leexianhui/CG4002/hardware/2 players/README.md

# 2 players

Firmware for the six ESP32 boards (three per player), plus a laptop-side
listener for their debug and result output.

| Board | Player 1 | Player 2 |
|---|---|---|
| Right wrist (hub) | `p1_right_wrist/p1_right_wrist.ino` | `p2_right_wrist/p2_right_wrist.ino` |
| Torso | `p1_torso/p1_torso.ino` | `p2_torso/p2_torso.ino` |
| Left wrist | `p1_left_wrist/p1_left_wrist.ino` | `p2_left_wrist/p2_left_wrist.ino` |

Open a board's folder in the Arduino IDE (board: ESP32 Dev Module) and upload.
The player 1 and player 2 sketches are identical except for `PLAYER_ID`, so any
change to one must be made to both. Label the boards, because a player 2 board
flashed with a player 1 sketch pairs with the wrong player.

## How it works

1. **Waiting.** Each board calibrates its gyro at boot, so keep it still.
   The LEDs blink amber until the hub hears fresh poses from both the torso
   and the left wrist.
2. **Weapon detection.** The hub (right wrist) compares both wrists' gravity
   directions against a reference stance for each weapon (sword & shield,
   spear, mace). Holding one stance steadily for 3 s locks that weapon. The
   LEDs are green while sampling and blue while a stance is being held.
3. **Locked.** The weapon stays fixed until reboot, and the LEDs show its
   colour (cyan, magenta or orange). The hub splits its own motion into
   candidate actions, and each candidate into strokes. A stroke is one
   coherent rotation, measured relative to its own peak, so a slow swing is
   found the same way as a fast one.

   Each stroke is compared with a strike template for every action. A
   template records which way the arm rotates, which way the hand is pushed,
   how far the arm turns, and how much the torso turns with it. The torso's
   beacons supply the torso data.

   A thrust barely rotates, so it's found as a push stroke instead: a burst
   of linear acceleration, with gravity tracked by the gyro. It's compared
   with a thrust template on three measures: push direction, how far the hand
   travels before it stops, and how little the wrist turns. A push is
   rejected if it is the lead-in to a swing in the same candidate.

   - **Accepted:** the stroke is close enough to its nearest template
     (the locked weapon's `ACTION_LIMITS` distance, with the sword/shield live-play
     tolerances below) and isn't the return to guard after the strike
     before it. It gives a short buzz and a green flash, and the hub asks the
     torso for the same time window of its samples.
   - **Rejected:** a red flash.

   Segmentation uses each stroke's relative peak. Some acceptance safeguards
   below also use absolute speed and duration. Every stroke is logged as a
   `Stroke ...` debug line with its features and decision.

   The templates are fitted from recordings by `fit_strike_model.py`, which
   writes weapon-specific strike, thrust, and limit tables into both hub
   sketches. The current rows were fitted from the 76 labeled player 1 debug
   sessions, including five explicitly attested grip overrides.
   Refit after changing how a board is strapped on.
   `speed_study.py` checks a model offline before you flash it.

   The sword/shield hubs also apply narrow tolerances from the 2026-10-19
   labeled player 1 captures. Horizontal and diagonal strikes allow distance
   1.75 instead of 1.50. A missed uppercut may use a 35-degree axis spread
   and distance 2.25 only when it rotates at least 60 degrees, peaks above
   250 dps, and has torso ratio at least 0.070. This keeps recorded guard
   raises from passing the wider match. Thrust allows 65 degrees of wrist
   rotation before a penalty. Its distance limit is 1.50 for pushes peaking
   at least 1.50 g, and 1.10 for weaker pushes (the fitted limit is 1.00).
   A push rotating over 55 degrees must travel at least 0.65 m so a recorded
   flick does not pass the wider thrust check. These adjustments are outside the
   generated model block and are applied only to sword/shield. The fitter's
   printed limits describe the generated baseline; check these live-play
   allowances with fresh labeled captures after flashing.

   Player 2 also accepts a second sword/shield uppercut wrist orientation seen
   in the 2026-10-21 `uppercut` capture. It requires a full swing (at least
   350 dps and 60 degrees of rotation), torso participation, and a close
   match to that capture's axis and push direction. The same conditional code
   is in both hub sketches, but activates only for `PLAYER_ID=2`. Recheck
   uppercuts and accidental accepts on the physical boards after flashing.

   Both hubs cap the normalised rotation-angle error at +/-0.75 for all
   rotation strikes. Uppercuts have no angle penalty from 60 to 220 degrees
   and an axis spread of at least 35 degrees, including the alternate player 2
   grip. Outside that reference range the angle penalty grows gradually and
   is capped; this is not a hard accepted-angle range. The uppercut speed and
   torso gates still apply.

   Spins retain the 250-degree minimum coherent wrist rotation, but have no
   angle penalty from 250 to 720 degrees. Spin matching allows at least a
   45-degree axis spread, a 60-degree push-direction spread, and distance 2.25.
   A matched spin is exempt from return-to-guard suppression, including after
   a non-spin strike. Torso data is still required. These allowances favour
   fewer missed attacks and may admit more handling movements; validate with
   multiple players and the non-action recordings below. A spin split into
   strokes below 250 degrees can still miss; inspect the stroke logs before
   reducing that minimum or changing segmentation.

   These runtime allowances are outside the generated tables. Offline fit and
   replay results do not validate them unless the same policies are implemented
   in those tools; confirm behaviour on the boards after flashing.

   The November 2026 P2 captures add recorded forward-stroke variants to the
   action patterns in both hubs. Each stroke is scored against the original
   and recorded patterns in one matching pass. When committing an event, an
   original accept has priority; a candidate with no original accept may emit
   its best recorded-pattern match. That match keeps separate return history
   so it cannot suppress a later original accept. It emits at most one added
   segment per candidate.
   The examples and inferred attempt windows are generated by
   `python hardware/lenient_p2.py --write` from the archived
   `logs/himeth_v1` captures and Lin's newer `logs/p2` mace-thrust capture.
   Mace thrust also allows distance 0.95 (fitted limit 0.75); a recorded
   high-rotation thrust supplies one additional pattern. Review
   `hardware/p2_attempts.csv` because the recordings have no explicit
   per-repetition boundaries. Run `python hardware/lenient_p2.py` to audit
   logged-feature coverage without rewriting sketches. The examples also
   run on P1, so validate P1 live before relying on the added behaviour.
   The November raw CSVs contain wrist samples only, with four inferred
   windows lacking raw samples; the audit uses the firmware's logged stroke
   features and torso-beacon counts for those windows. A full raw replay
   needs the torso stream as well.
   P1 has its own bank, `P1_LENIENT_MODEL`, generated by
   `python hardware/lenient_p1.py --write` from the P1 action captures
   (`logs/himeth_v2`, 2026-11-09, all 5 actions x 3 weapons, and the
   2026-11-12 horizontals in `logs/p1`). It is wider (raw distance <=
   `P1_LENIENT_MAX_DIST` = 1.0) and matches for any locked weapon. A pattern
   must pass the commitment gate, and a pattern that would match any stroke in
   a fake/guard session (`p1`, `p2`, `p2_v1`, `p2_v2`) is pruned. Both hubs
   use both banks; the sketches differ only in `PLAYER_ID`. The `Combined`
   debug line shows `bank=p1|p2`.

   Commitment gate (`rotationCommitReject` / `pushCommitReject`, mirrored in
   `figpipe/handling.py`) runs before every accept path, fitted and lenient:
   `flick` (rotation < 60 deg), `slow` (peak < 250 dps over >= 650 ms, or
   < 320 dps over >= 750 ms; spins exempt), `guard_raise` (lift-shaped axis
   with rotation < 100 deg and torso ratio < 0.10, or torso ratio < 0.05) and
   thrust `short` (reach < 0.40 m or peak < 0.9 g). A push whose wrist
   angular speed peaks above 300 dps **and** reaches < 0.70 m is `flick`
   (flicks snap the wrist at 300-520 dps but travel <= ~0.55 m; hard real
   thrusts can reach 300-443 dps but travel 0.60-0.99 m; the push debug line
   logs the speed as `gyroPk=`). A horizontal/diagonal match with torso ratio
   < 0.08 is `torso_quiet` (flicks 0.03-0.07), unless it is a full-power cut
   (rotation >= 130 deg and peak >= 450 dps): P1's sword verticals/diagonals
   are arm-driven (torso 0.05-0.10) but turn 153-178 deg at 550-770 dps,
   while those flicks turn 68-120 deg. A stroke
   within `GUARD_EDGE_MS` (600 ms) of a guard entry or exit is rejected as
   `guarding`; swings while the guard is held count. Logged-feature replay at
   generation time (`python hardware/lenient_p1.py`): P1 forward strokes
   accepted 130 -> 257 of 292 (241 leave-one-session-out), P2 70 -> 121 of
   132, and accepts in all fake/guard sessions 161 -> 13.

   Guard state can't get stuck: the left wrist re-sends its current guard
   state every `GUARD_STATE_REPEAT_MS` (500 ms) while locked, the hub acts
   (buzz, relay `GUARD_EVENT`, `guard_state` result line) only on a change,
   and without a guard packet for `GUARD_STALE_MS` (1.5 s) a GUARDING hub
   drops to IDLE and logs `state=IDLE reason=stale`. Flash the left wrist and
   hub together: an old left wrist without repeats would have every guard
   timed out after 1.5 s.

   Guard (left wrist) compares the gravity pose with every reference of the
   locked weapon, each with its own enter/exit radius, arm distance and
   arrival speed: sword 10/20 deg, from > 80 deg away at >= 350 dps (a real
   sword guard comes up from rest; fakes start half-lowered and rise slowly);
   spear 15/25 for P2's pose and for P1's (28, -76); mace 25/35 for P2's pose
   and 20/30 for P1's. Entry needs the gyro EMA <= 100 dps for 400 ms, and
   within the last 1.5 s the arm must have been beyond every arm distance with
   the gyro EMA peaking at the arrival speed: hovering near the pose cannot
   trigger it, and each arrival allows one entry. Tune with
   `python hardware/guard_replay.py --sweep` (raw left-wrist replay); on the
   November captures it gives 4 false guard episodes (previous firmware 20)
   and 85 % guard coverage (previous 68 %).

### Mace/spear preparation rejection (November 8)

Both hub sketches carry the same policy, enabled only for `PLAYER_ID=2` because
these signatures were recorded with P2's mounting. P1's acceptance rules are
unchanged. P2 rejects recorded upward preparation signatures before updating
strike history. Otherwise a lift can pass as an uppercut and suppress the actual
diagonal cut as its return. The check applies to original and fallback matches;
a push overlapping a rejected handling stroke cannot re-enter as a thrust.
Logs report `guard_raise`, `return`, or `handling` for these rejections.

Three additional downward diagonal orientations cover the reviewed P2 mace and
spear strokes. They retain the weapon's distance and torso limits and require
at least 350 dps, 100 degrees of rotation, and duration at most 750 ms. These
conditions gate the additional variants, not all diagonal attacks. Earlier
upward mace diagonal fallback exemplars are blocked by the preparation check.

Run from `hardware`: `python -m unittest tests.test_preparation tests.test_handling tests.test_strokes`.
The checked-in [feature fixture](../tests/fixtures/p2_preparation.csv) retains
346 logged strokes, including pushes and genuine uppercuts. The seven-session
replay rejects all strokes in the two new fake captures and detects 12/12 new
mace, 9/9 archived mace, and 8/8 archived spear downward targets. Diagonal
targets are inferred from the signed downward strokes, not independently timed
annotations. Optional raw replay also checks zero fake accepts and coverage of
the 12 new mace targets. Raw segmentation and action hints can differ from the
logged features; this validates acceptance, not the separate AI classifier.
The new P2 folder contains no spear diagonal capture, so that regression uses
the archived November 6 capture. Rebuild and reflash the P2 right-wrist hub and verify live
raises, slow/fast diagonals, and genuine uppercuts on P2.

## Recording and fitting weapon-specific actions

Use the same sensor mounting for both players. Record one player at a time so
each session has a unique timestamp. The fitter reads the hub's `Stroke` debug
lines, and checks each session's filename weapon against its periodic
`Active weapon=<name>` line. The lock line is now available with `RAW_STREAM 0`;
raw samples are optional diagnostics and are not used for fitting.

For each of `sword_shield`, `spear`, and `mace`, record at least eight clear
repetitions of each of the six actions at slow, normal, and fast speeds. Record one session
each of `fake_flick`, `fake_handling`, `fake_walking`,
`fake_body_turn`, and `guard_raise`. For example:

```
python listener_2p.py --players 1 --label vertical_slow_spear
python listener_2p.py --players 1 --label fake_handling_spear
```

The fitter reports usable counts and stops if any action and speed group has
fewer than eight. The debug log must contain all `Stroke` lines and the closing
`Candidate ENDED` line for a thrust candidate. Inspect the printed training
comparison, especially thrust misses and non-action accepts, before using
`--write`.

The 2026-10-13 training check found mace thrust at 5/10 slow, 6/10 normal,
and 13/22 fast with the selected limit. Raising that limit admitted more
recorded non-actions, so test mace thrust and handling carefully after flashing.
Some sword/shield diagonals were accepted as another strike type; verify action
identity as well as detection in live play.

The hub keeps its weapon lock until reboot. Reboot it before changing weapon,
hold the new weapon's ready stance until it locks, and confirm the matching
`Active weapon=<name>` line before starting each labeled capture. Five
2026-10-13 spear/mace top-ups logged `Active weapon=sword_shield`; the recorder
confirmed the physical spear/mace grips. `logs/p1/weapon_grip_overrides.csv`
records those specific attestations. The fitter checks both labels and the
logged lock, retains the logged lock for diagnostics, and uses the attested
physical grip for fitting. Any other mismatch still stops fitting.

From the repository root, fit and inspect the generated model before writing:

```
python fit_strike_model.py --logs "2 players/logs/p1"
python fit_strike_model.py --logs "2 players/logs/p1" --write
```

The fitter excludes older sessions with no weapon label. The optional `_train`
suffix is equivalent to omitting a split. You can add `_val` sessions later
for a separate offline check, but they are not needed to fit the model. It fails
if a labeled session lacks a locked-weapon debug line, if the labels conflict
without a specific attestation, or if any group lacks enough usable strokes.
When `_val` recordings are supplied, it reports held-out detection and
non-action accepts against the model currently in the hub sketch. Otherwise,
flash both hubs after fitting and check detection and accidental accepts in
live play.

The hub broadcasts the current phase every 100 ms, so a board that reboots
rejoins on its own.

## Network

All six boards join the laptop hotspot set by `ssid` / `password` at the top of
each sketch. Windows Mobile Hotspot allows at most 8 clients, which leaves 2
spare. Each player's boards use their own block of UDP broadcast ports, so the
two players never process each other's packets. The `playerId` in every packet
header is checked as a second guard.

| Port | Player 1 | Player 2 | Carries |
|---|---|---|---|
| LINK | 4210 | 4220 | torso beacons, segment requests/acks (after lock) |
| DEBUG  | 4211 | 4221 | debug text -> laptop |
| POSE | 4212 | 4222 | wrist/torso poses, hub phase status |
| RESULT | 4213 | 4223 | milestone lines -> laptop |

## Build options

These are set at the top of each sketch.

| Option | Default | Effect |
|---|---|---|
| `PLAYER_ID` | 1 / 2 | Which player the board belongs to |
| `WIFI_SLEEP_DISABLED` | 1 | Turns modem sleep off for lower, steadier latency |
| `LATENCY_TEST` | 0 | Hub pings the torso and logs RTT and beacon inter-arrival times. Set it on both the hub and the torso |
| `LOCAL_FEEDBACK_TRIGGERS` | 1 | Hub drives its own LED/buzz feedback. Set to 0 when the laptop drives it |
| `RAW_STREAM` | 1 for the current P2 hub/torso sketches; 0 elsewhere | Hub and torso stream every IMU sample on port 4214/4224, for recordings. The listener writes it to `raw_<time>_<label>.csv`. Keep it enabled on both the hub and the torso when collecting raw data |

## Listening on the laptop

```
python listener_2p.py --label <label>
```

This prints every line tagged `P1`/`P2`, with a `*` marking result lines, and
writes per-player CSVs:

```
logs/p1/debug_<time>_<label>.csv   logs/p1/result_<time>_<label>.csv
logs/p2/debug_<time>_<label>.csv   logs/p2/result_<time>_<label>.csv
logs/pN/raw_<time>_<label>.csv      (RAW_STREAM builds: one row per IMU sample)
```

For speed recordings, use labels like `vertical_slow`, `vertical_normal` and
`vertical_fast`. The `logs/` folder isn't in git, so back it up.

Use `--players 2` to listen to one player only. Use `--results-only` to hide
debug lines on screen; they are still logged.
