leexianhui/CG4002/hardware/gateway/README.md

# Real hardware gateway integration

Builds the **actual imported two-player sketches** in `hardware/2 players/`.
The right-wrist hub is the final board in that supplied topology. By default every link is BLE
and no board starts Wi-Fi (`CG_GATEWAY_NODE_LINK=1`):

```text
left wrist -- BLE node link --+
torso ------ BLE node link --+--> right-wrist hub -- BLE v1 --> relay
                                   (own IMU too; central to its nodes, peripheral to the relay)
```

Why: the ESP32 has one 2.4 GHz radio. With the hardware team's Wi-Fi links the hub time-shared it
between Wi-Fi (nodes) and BLE (relay), and stopped hearing its nodes once the relay connected (all
LEDs stuck yellow). Wi-Fi also used heap the BLE stack needed: with the segment uplink added, the hub
had 91 KB free before BLE init and Bluedroid aborted (`assert failed: vQueueDelete`). Without Wi-Fi
the hub's static RAM drops from 105,932 to 88,772 bytes and no Wi-Fi driver heap is allocated.

**Node link (`src/link.cpp`, `include/gateway_link.h`).** Each node is a GATT server advertising a
player- and role-specific service UUID (`4347<player><role>-6c69-6e6b-8000-000000000000`, names
`CG-P1-TORSO`, `CG-P1-LEFT`, ...), so a hub only ever connects to its own player's nodes. The hub
scans (20 ms of every 80 ms, only while a node is missing), connects, subscribes to the node's notify
characteristic (`...01`) and writes to its write characteristic (`...02`, no response): three
connections in all, the controller's limit. Either side reconnects on its own. The sketches'
send/receive code is unchanged: their `WiFiUDP` sockets become `GatewayLinkUdp`, a drop-in with the
same calls. A packet's UDP port becomes a one-byte tag (LINK, POSE, and the continuous-mode sample
port); HubStatus goes to both nodes, LINK (beacons, segment requests/acks) only to the torso. The
laptop-only ports (DEBUG, RESULT, RAW) are dropped; `debugLog` still prints on serial. The hub asks
for 15-30 ms connection intervals, as on the relay link. Bluedroid also reports the node links to
the relay's GATT server, so `comms/firmware/src/main.cpp` tracks the relay connection by link role
and notifies it alone.

**UDP mode (`-DCG_GATEWAY_NODE_LINK=0` on all three boards of a player).** The hardware team's
original Wi-Fi UDP broadcast on their hotspot, for their laptop listener and recording tools
(`listener_2p.py`, `fit_strike_model.py`). The hub then has its old memory budget again, which the
event-mode segment queue no longer fits: if it reboot-loops at BLE init, also add
`-DCG_GATEWAY_EVENT_MODE=0`, or record with the hardware team's own non-gateway sketches.

Most integration code lives here. The six teammate sketches have opt-in `CG_HARDWARE_GATEWAY`
hooks for initialization, sample export, and (node link) swapping their Wi-Fi join and sockets. Hubs also poll incoming samples and drive the existing
motor pin from authenticated engine feedback. Left wrists keep sampling after weapon lock but
still stop pose detection/broadcasts after lock. Original Arduino builds without the flag retain
their behavior. Stance detection, segmentation, templates, wiring and existing UDP messages stay
in the teammate sketches. Their `sendSegmentToUltra96` logging stub is not used as an AI result.

The shared transport lives in `comms/firmware/src/main.cpp` with explicit hardware I/O hooks;
the gateway build disables synthetic IMU data and buttons. The demo's default behavior is unchanged.
BLE handshake/retries run on a separate FreeRTOS task, with a locked sample mailbox and a bounded
feedback queue. Sensor reads, UDP and motor writes stay on the hardware main thread.

## Boundary

- Existing BLE v1 framing, encryption, UUIDs, sequences, reliable weapon/feedback and time sync.
  Firmware version 5; packet range 0x40–0x4F stays reserved.
- **Event mode (default, `CG_GATEWAY_EVENT_MODE=1`).** One classifier window per accepted action,
  holding exactly what `ai/models/ACTION_FINAL` takes: 100 rows at 50 Hz (2 s), 18 axes per row =
  right wrist, left wrist, torso. Since 2026-11-04 (before that, only the right wrist reached the AI):
  - **All three boards feed the hub.** Torso and left wrist send their 30-byte sample every 20 ms over
    the node link (the same packet as continuous mode). The hub puts its own 100 Hz samples and the
    nodes' into `GatewayHistory` (`include/gateway_segments.h`): the last 4 s on a 20 ms grid in hub
    time. Node samples are moved onto the hub clock by `GatewayNodeClock` (smallest recent
    arrival-minus-source offset, so radio jitter doesn't shift them).
  - **The hardware team's segmenter still decides what is an action.** Its `acceptSegment()` calls
    `sendSegmentToUltra96()`, which hands over the accepted stroke (plus its 25% padding). The hub
    uses only its time span: the window ends so the stroke's midpoint is row 50 (1.0 s), the position
    the AI's training data has. It waits at most 400 ms past acceptance for that (otherwise the window
    ends 400 ms after acceptance), plus 80 ms for node samples still on the radio, then copies the
    100 rows out of the history. Real samples on both sides, no padding.
  - **Matching the training boards' chip filter.** ACTION_FINAL was recorded on these same MPU6500
    boards with the chip's low-pass on (`0x1A = 4`: gyro ~20 Hz, ~9.9 ms delay; accelerometer
    unfiltered, as the training data's flat accel noise confirms) and read at 50 Hz. The game sketches
    keep the chip filter off for their own swing detection, so every board runs the AI's copy of its
    gyro through `GatewayLowPass` (`include/gateway_samples.h`: 2nd-order Butterworth, 20 Hz at
    100 Hz, ~9.8 ms delay) before every other sample is taken. The accelerometer is left as it is. The
    sketches' own detection still gets the raw readings.
  - **Validity.** A sensor present in fewer than 80 of the 100 rows is flagged not valid; the relay then
    sends the left wrist as its at-rest placeholder and the torso as absent, and the AI fills them with
    its training mean. A short gap repeats the sensor's previous row. Serial prints
    `[segment] window seg=... right=1 left=1 torso=1` for every window.
  - **Uplink.** A 3-slot queue (one sending, one waiting, one filling; when full, the oldest unsent
    window is dropped and logged; one older than 1.5 s is discarded unsent). Each window goes once as
    20 three-IMU `SEGMENT_CHUNK`s (wire_protocol.md §3, flags bit 0): 5 rows of 18 axes per 234-byte
    frame, up to 4 unACKed, each retried with identical ciphertext (150 ms, doubling, five sends). The
    relay ACKs each chunk, reassembles, and sends exactly one classifier request with `dominant`,
    `offhand` and `torso`. It still accepts an old hub's dominant-only segments (flags 0).
  - **Cost.** Hub static RAM 88,788 -> 101,316 bytes (history 8.8 KB, window queue 10.8 KB). Node links
    carry 50 Hz samples from both nodes (the torso also keeps its 50 Hz beacons).
- **Continuous mode (`-DCG_GATEWAY_EVENT_MODE=0` on hub and nodes, `segment_mode: false` on the
  relay).** Right/left wrist and torso channels in 50 Hz `SENSOR_FRAME`s, windowed by stride on the
  relay. Axes preserve the original board orientation; accel uses 2048 counts/g, gyro 16.4
  counts/degree/second, with int16 saturation.
- Both modes: internal port 4215 (P1) / 4225 (P2) (a node-link tag over BLE) carries one
  30-byte sample at 50 Hz from each non-hub node. Packed little-endian: magic u16=0x4743, version u8=1, player u8, role u8,
  reserved u8=0, boot u32, sequence u32, source_ms u32, six int16 axes. Roles: hub=0, torso=1,
  left=2. Existing diagnostic RAW streams and ports remain unchanged.
- Reject wrong identity/format, duplicate and reordered samples. A new boot can replace a stream
  after it has been stale for 100 ms. Samples older than 100 ms are omitted and wrist stale flags
  are set. This is arrival-age detection, not synchronized acquisition: peer clocks are retained
  internally but current BLE frames use the hub clock and latest received samples. Radio buffering
  and cross-board alignment must be measured before agreeing the real AI input contract.
- Continuous mode: BLE v1 has no torso stale flag. Missing torso slots are zero, which the classifier
  treats as an absent sensor (a constant block). Missing wrist slots are zero **and marked stale**,
  never silently treated as measurements. (Event mode has per-sensor valid flags instead.)
- The real locked posture selection is sent using the existing weapon-event packet. UID is all
  zeros because this hardware does not supply RFID. Selection is announced again after reconnect.
- Engine feedback codes 0–3 drive hub vibration using supplied intensity, duration and repeat count
  (150 ms between repeats; accepted bounds: 0–100%, 1–2000 ms, 1–10 repeats). ACK means queued for
  application, not proof of physical motor movement. Duplicate packets do not queue twice; a full
  queue is not ACKed, permitting retry. Local hardware feedback remains and engine vibration takes
  priority while active. LED behavior stays with the original hardware logic.
- Battery millivolts are zero because no battery telemetry is supplied; they are not measurements.
- Internal node packets (BLE node link or UDP) are unauthenticated, as the original hardware links
  were. Relay-link authentication does not authenticate their origin.

## Build and use

From this directory, set `CG_GATEWAY_PSK_HEX` to the matching relay player's existing 32-hex-digit
key in the process environment, then run:

```powershell
..\..\pio-venv\Scripts\pio.exe run -e p1_hub -e p1_torso -e p1_left
..\..\pio-venv\Scripts\pio.exe run -e p2_hub -e p2_torso -e p2_left
..\..\pio-venv\Scripts\pio.exe test -e native_test  # needs host gcc/g++ on PATH
```

Use the matching player key for each hub build. Nodes need no relay key. Keys are written only
into ignored `.pio/build/<env>/private/gateway_secret.h`; firmware binaries also contain that key.
Without a key the hub build fails. Compile checks used an all-zero dummy key: **rebuild with the
real key before uploading**. No upload is part of these commands.

Profiles select FireBeetle ESP32 for hubs and ESP32 Dev Module for other nodes. Verify each physical
board, flash size and serial port before uploading. The hub requires the supplied 3 MB app partition
(`huge_app.csv`, no OTA slot) with at least 4 MB flash; it does not fit the usual small app partition.
The selected FireBeetle profile defaults to 16 MB flash, so match that setting to the physical board.
Existing hardware Wi-Fi settings remain in the teammate sketches and are used only in UDP mode.

Serial lines that show the node link is up (BLE mode). The sketches' own `initialized at IP 0.0.0.0`
and `wifi_sleep=` lines are harmless in this mode: no Wi-Fi is started.

- Torso / left wrist: `[link] advertising as CG-P1-TORSO, waiting for the hub`, then
  `[link] hub connected`. Its LED leaves the waiting pattern once HubStatus arrives.
- Hub: `[ble] free heap after init: ...`, `[link] scanning for torso and left wrist`, then
  `[link] torso connected` and `[link] left_wrist connected`, then the sketch's `all_nodes_ready`.
- A node that drops: `[link] torso disconnected (reason 0x..), scanning again` on the hub and
  `[link] hub disconnected, advertising again` on the node; they reconnect on their own.

Scan for `CG4002-Hardware-P1` / `CG4002-Hardware-P2`. In each relay process's `.env.relay`, set
`CG_RELAY_TRANSPORT__BLE_ADDRESS`, `CG_RELAY_PSK_HEX`, `CG_RELAY_ENGINE_LINK__BEARER_TOKEN`,
`CG_RELAY_ENGINE_LINK__HOST`, `CG_RELAY_ENGINE_LINK__CA_CERT_PATH` and `CG_RELAY_ULTRA96__HOST`
as appropriate. From `comms/`, run `cg-relay --config configs/relay.hardware.p1.yaml` (or P2).
These profiles use segment mode (`windowing.segment_mode: true`). The classifier must be started
separately: the relay always
connects to the configured classifier TCP host/port. `CG_RELAY_ULTRA96__USE_MOCK=true` only bypasses
SSH tunnel setup; it does not start or select a classifier implementation.

For a first deterministic, no-combat check, run from `comms/` in a separate terminal:

```powershell
.\.venv\Scripts\python.exe -m cg_comms.mock.ultra96_sim --host 127.0.0.1 --port 8888
```

Point the relay's `CG_RELAY_ULTRA96__HOST` / `CG_RELAY_ULTRA96__PORT` at that process. Its default
reply is IDLE; use an action-result `--scenario` for repeatable combat outcomes. This verifies the
connection and gameplay pipeline, not gesture recognition. The old button `--trigger-map` does
not apply to these hardware windows. Do not start `integration_mock` alongside
real relays: that launcher also creates simulated devices and relay sessions for both players.

## Physical acceptance still required

1. Build/upload the three matching profiles for one player (**all three**: the nodes must be reflashed
   too, or they send no samples in event mode), choose a weapon, verify the BLE handshake, that
   `[ble] free heap after init` stays healthy with the larger hub RAM, that `ble_connected
   mtu_payload` is at least 234, and that each accepted swing gives `[segment] window ... right=1
   left=1 torso=1` on the hub and exactly one `segment_received` (with `left=True torso=True`) and one
   `segment_classified` on the relay. In continuous
   mode instead verify 50 Hz reception and move each wrist separately to verify role/axis mapping.
2. Swing repeatedly as fast as possible: watch for `[segment] queue full` / `undelivered` on the hub
   and `segment_abandoned` on the relay. Repeat for hub/relay reconnect and weapon reannouncement.
3. Send engine feedback, retry the same packet, confirm one queued vibration; verify PWM/duration.
4. Repeat with both players together (six node links and two relay links in one room). Measure
   node-link drops (hub `[stats]` lines), torso beacon rate (50 Hz expected), relay link loss,
   timing alignment and heap during a sustained run. Compile success does not establish these.
5. Complete phone calibration acceptance, then run with the real AI (`ai/classifier_server.py`).

Host checks on 18 October 2026 (BLE node link): all six gateway profiles, UDP-mode and
continuous-mode variants, and the demo firmware cross-compile. Nothing flashed or tested on boards.

Host checks on 17 October 2026 (event mode): 316 Python tests passed, all six gateway profiles and the
demo firmware cross-compile, and the chunk struct's field offsets were checked against the Python
layout with the ESP32 compiler. The new native segment-queue test (`test/test_segments`) is not yet
run (no host g++ here). Nothing has been flashed or tested on boards yet.

Host checks on 14 October 2026: 286 Python tests passed; both relay profiles load correctly
with environment-supplied addresses/credentials. Six native C++ boundary tests were added, but
could not execute on this machine because host gcc/g++ is absent. ESP32 cross-compilation
does not substitute for those native tests. No boards were flashed.
