leexianhui/CG4002/design_report/09_references.md

# References

1. Lara, O. D., & Labrador, M. A. (2013). A survey on human activity recognition using wearable sensors. *IEEE Communications Surveys & Tutorials, 15*(3), 1192–1209. https://doi.org/10.1109/surv.2012.110112.00192

2. Jiang, W., Ye, X., Chen, R., Su, F., Lin, M., Ma, Y., Zhu, Y., & Huang, S. (2021). Wearable on-device deep learning system for hand gesture recognition based on FPGA accelerator. *Mathematical Biosciences and Engineering, 18*(1), 132–153. https://doi.org/10.3934/mbe.2021007

3. *Accelerometer & Gyroscope Module (MPU6050)*. SunFounder Ultimate Sensor Kit documentation. https://docs.sunfounder.com/projects/ultimate-sensor-kit/en/latest/components_basic/05-component_mpu6050.html

4. NXP. *MFRC522 standard performance MIFARE and NTAG frontend*. https://www.nxp.com/docs/en/data-sheet/MFRC522.pdf

5. Espressif Systems. *ESP32-C3 series datasheet version 2.4*. https://documentation.espressif.com/esp32-c3_datasheet_en.pdf

6. DFRobot. *FireBeetle ESP32 IoT microcontroller: Unleash IoT potential*. DFRobot Wiki. https://wiki.dfrobot.com/dfr0478/

7. *WS2812B intelligent control LED integrated light source features and benefits*. https://cdn-shop.adafruit.com/datasheets/WS2812B.pdf

8. *TP4056 datasheet*. https://dlnmh9ip6v2uc.cloudfront.net/datasheets/Prototyping/TP4056.pdf

9. Espressif Systems. *ESP-NOW Programming Guide*. https://docs.espressif.com/projects/esp-now/en/latest/

10. Bluetooth SIG. (2025). *Bluetooth Core Specification Version 6.1*. https://www.bluetooth.com/specifications/specs/core-specification/

11. Fette, I., & Melnikov, A. (2011). *RFC 6455: The WebSocket Protocol*. Internet Engineering Task Force. https://www.rfc-editor.org/info/rfc6455/
