leexianhui/CG4002/docs/DETERMINISTIC_KEYBOARD_DEMO.md

# Deterministic keyboard assessment and the existing GPIO demo

For transmission-speed trials and the complete professor-facing live/video script, use
[COMMS_LIVE_AND_VIDEO_GUIDE.md](COMMS_LIVE_AND_VIDEO_GUIDE.md).

2026-09-28. This revision follows your updated instruction: random dummy selection, a modifying
board transform, and random AI events are no longer required for the keyboard demonstration.
The earlier implementation followed the original assessment brief's explicit requirements for
those three behaviours; they were demonstration fixtures, not requirements of BLE or classification.

## Physical baseline and scope

Your attached **“CG4002 Communications Architecture — Testing Completed So Far”**, dated 28 September,
is the hardware baseline. It reports successful two-player 50 Hz streaming, a bounded 75-second
trial with 74.779 seconds common coverage, keyboard-to-Unity delivery, decoded packet inspection,
1037-byte/33-chunk file upload and RAM readback with CRC/SHA-256 verification, controlled ACK loss,
and individual board/relay/classifier/engine/Unity restart recovery.

It does **not** establish actual out-of-range recovery, simultaneous 100/200 Hz performance,
the highest stable rate, or completion of the newly revised editable-keyboard demonstration.
The new code's software checks below do not turn those into completed physical tests.

Normal GPIO capture/mapping, continuous 50 Hz scheduling, file payloads/readback, `L` fault injection,
`D` packet sampling, connection management, timing profiles, endpoints and credentials are retained.
One additive display change forwards accepted weapon selections to Unity immediately, including
physical selections, using its existing `WEAPON_CHANGED` message handler.

## Controls

| Key | Operation |
|---|---|
| `a` | Ask the board to cycle its held weapon: NONE → SWORD → SPEAR → MACE → SWORD… |
| `b` | Send fixed editable variant **B** to the board; verify identity return; classify returned IMU |
| `c` | Same operation with fixed variant **C** |
| `d` | Same operation with fixed variant **D** |
| `F` | Existing file upload, CRC, RAM readback, byte/SHA-256 verification and saved returned file |
| `L`, then `F` | Existing deliberate one-upload-ACK-loss demonstration |
| `D` | Toggle sampled normal `SENSOR_FRAME` display; distinct from lowercase `d` |
| `Q` | Stop keyboard listening; streaming continues |
| Ctrl+C | Stop this relay process |

Other characters do not send assessment packets. Keys are never queued. Wait for an operation to
finish; `BUSY`, `OFFLINE`, `NO_WEAPON` and `UPSTREAM_OFFLINE` are explicit rejections. `a` needs a
streaming board and engine connection, but no prior weapon and no classifier connection. B/C/D
require a selected weapon and both upstream connections. File operations only require the board.

The physical action buttons remain independent. Keyboard `b/c/d` do not become GPIO trigger IDs
1/2/3 and do not edit the GPIO trigger map. Keyboard `a` and physical GPIO4 share the board's held
weapon, so either can advance the same existing round robin. The relay does not invent a separate
weapon sequence. A retransmitted `a` command must not cycle twice.

## What traverses the pipeline

```text
GPIO action button -> existing 50 Hz triggered capture -> normal multi-sample SENSOR_WINDOW --+
                                                                                        |
keyboard b/c/d -> fixed raw IMU -> encrypted BLE -> board identity reply                   |
             -> verify returned fields -> scale actual return -> one-sample SENSOR_WINDOW-+
                                                                                        |
                            same classifier TCP client -> ACTION_RESULT                  |
                            -> same relay confidence/correlation checks                  |
                            -> ACTION over engine WebSocket -> ACTION_RECOGNIZED -> Unity
```

The keyboard request still contains the complete real 42-byte sensor body inside its assessment
envelope. The board returns the raw sensor axes unchanged; relay conversion is the normal
accelerometer `/2048` g and gyroscope `/16.4` deg/s conversion. Timestamp/correlation metadata still
changes per transaction. This is **not** an encrypted-byte loopback or a direct action command.

The keyboard fixture remains a one-sample-per-hand `SENSOR_WINDOW`, with `triggerId=null` and a
`demoTraceId`. It does not claim to be a physical 40-sample gesture capture. The ordinary classifier
schema carries dominant/offhand samples; torso is verified in the BLE body but not classified.
Continuous sensor frames and the physical capture window builder run independently.

### Identity transform and protocol compatibility

The previous implementation had only transforms 1=negate, 2=add-keycode and 3=swap/scale.
There was no existing identity mechanism. Revision 3 adds **0=IDENTITY** for request keys b/c/d.
There is no separate transform field in the request: the key selects identity in both firmware
and Python; the reply explicitly reports `transform_id=0`, which the relay verifies along with
all returned sensor fields. Legacy arithmetic IDs remain available for low-level protocol fixtures.

`a` adds two small assessment packet types: `ASSESS_WEAPON_REQ` 0x46 (4-byte trace ID) and
`ASSESS_WEAPON_RESP` 0x47 (trace ID, device time, selected weapon; 9 bytes). They use the existing
authenticated codec, serialized operation lock, identical-request retries and board response cache.
The board invokes the existing GPIO weapon-cycle routine and announces its selection through the
existing RFID path. The correlated response can also confirm selection if that announcement is lost.
An expired/cancelled response cannot create a new action or cycle a weapon again.

Base wire version remains 1; demo firmware reports **firmware version 3**. The largest frame remains
76 bytes. Update Python and flash both boards together. New keyboard operations reject firmware
older than version 3 with a clear message. File formats are unchanged.
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
