leexianhui/CG4002/ai/models/ACTION_FINAL/confusion_matrix.png

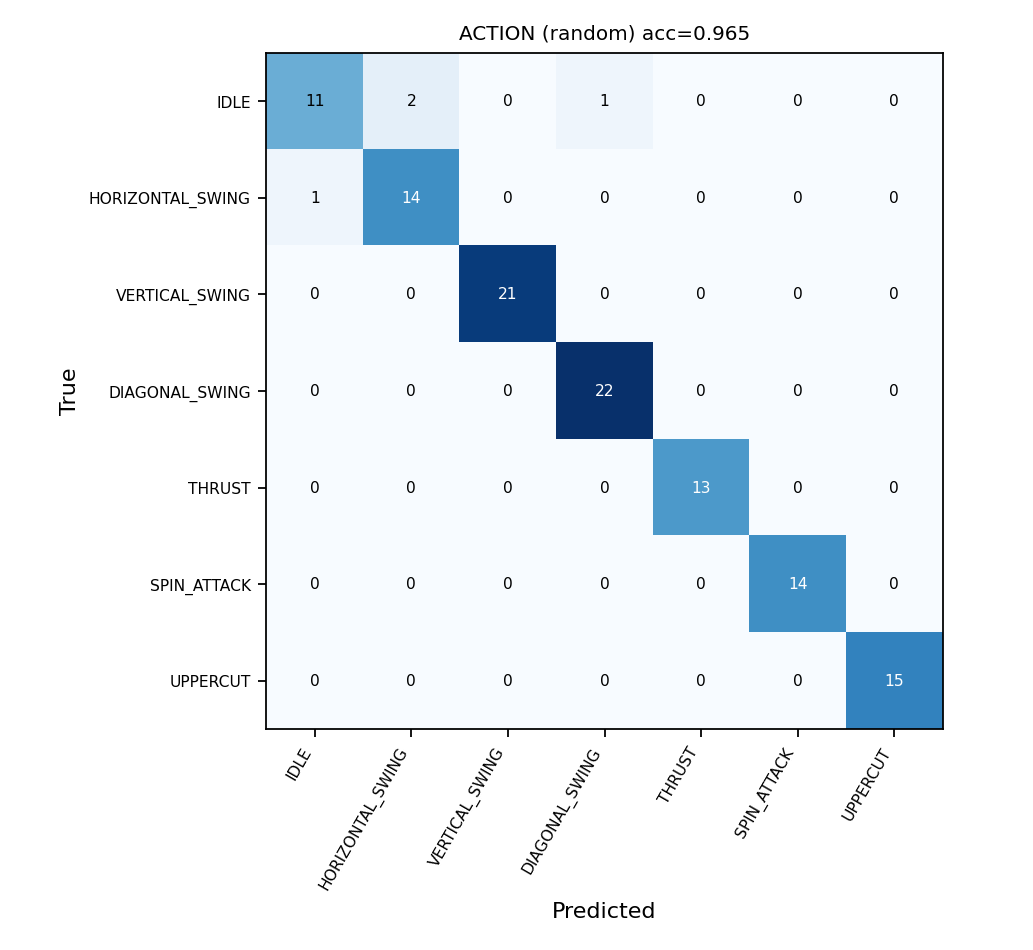
ai/models/ACTION_FINAL/confusion_matrix.png
