leexianhui/CG4002/ai/models/ACTION_FINAL/training_curves.png

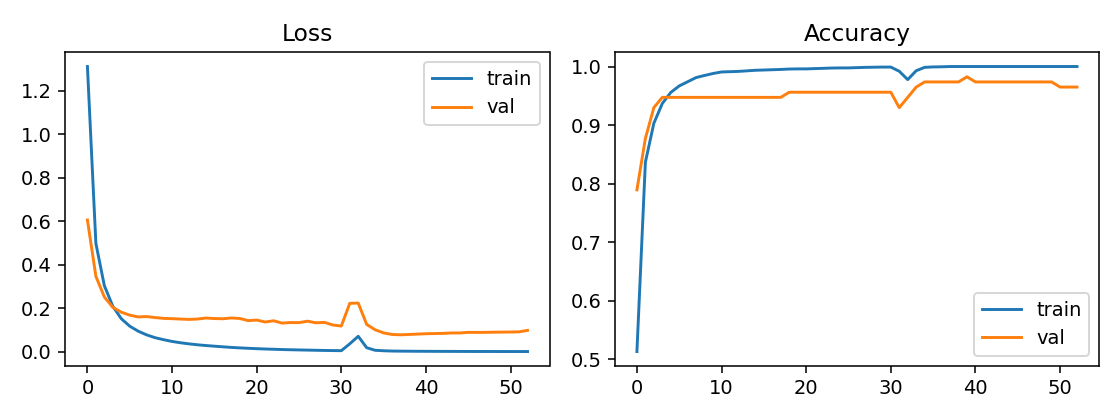
ai/models/ACTION_FINAL/training_curves.png
