leexianhui/CG4002/hardware/tests/fixtures/p2_preparation.csv

session | weapon | cand | expected | kind | t0 | t1 | peak | rot | reach | ax | ay | az | px | py | pz | torsoRatio | beacons | nearest | dist | accept
20261108_231414_fakes_mace | mace | 0 | 0 | rot | 258308 | 259161 | 245.5 | 95.3 | 0 | 0.647 | -0.715 | -0.265 | -0.186 | 0.247 | -0.951 | 0.894 | 67 | diagonal | 3.83 | 0
20261108_231414_fakes_mace | mace | 0 | 0 | rot | 259211 | 259862 | 188.4 | 55.5 | 0 | 0.577 | -0.614 | -0.538 | -0.340 | -0.858 | -0.385 | 1.033 | 44 | horizontal | 5.42 | 0
20261108_231414_fakes_mace | mace | 0 | 0 | push | 258719 | 260073 | 0.36 | 171.9 | 0.356 | -0.552 | 0.609 | 0.569 | 0 | 0 | 0 | 0 | 77 | thrust | 7.15 | 0
20261108_231414_fakes_mace | mace | 0 | 0 | push | 258850 | 259471 | 0.37 | 79.7 | 0.157 | 0.799 | 0.089 | 0.595 | 0 | 0 | 0 | 0 | 48 | thrust | 3.49 | 0
20261108_231414_fakes_mace | mace | 0 | 0 | push | 259562 | 260073 | 0.37 | 50.4 | 0.189 | 0.502 | 0.235 | 0.833 | 0 | 0 | 0 | 0 | 26 | thrust | 3.16 | 0
20261108_231414_fakes_mace | mace | 0 | 0 | push | 259822 | 260073 | 0.36 | 19.1 | 0.063 | 0.878 | 0.461 | 0.128 | 0 | 0 | 0 | 0 | 12 | thrust | 2.76 | 0
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
