leexianhui/CG4002/hardware/tests/fixtures/p2_handling.csv

session | weapon | action | reject | t0 | t1 | peak | ax | ay | az | px | py | pz
raw_20261108_214230_guard_raise_mace.csv | mace | vertical | return | 241181 | 242193 | 209.333227 | -0.095701 | -0.464007 | -0.880647 | -0.053591 | 0.734633 | -0.676345
debug_20261108_214230_guard_raise_mace.csv | mace | uppercut | guard_raise | 240125 | 240496 | 631.6 | 0.179 | 0.493 | 0.852 | 0.876 | 0.397 | -0.274
debug_20261108_214230_guard_raise_mace.csv | mace | uppercut | guard_raise | 243257 | 243598 | 641.7 | 0.096 | 0.493 | 0.865 | 0.510 | 0.721 | -0.469
debug_20261108_214230_guard_raise_mace.csv | mace | uppercut | guard_raise | 246797 | 247088 | 546.0 | 0.139 | 0.468 | 0.873 | 0.354 | 0.819 | -0.451
debug_20261108_214230_guard_raise_mace.csv | mace | vertical | return | 247692 | 248916 | 94.1 | -0.156 | -0.452 | -0.879 | 0.087 | 0.976 | 0.199
debug_20261108_214230_guard_raise_mace.csv | mace | uppercut | guard_raise | 250267 | 250568 | 516.8 | 0.179 | 0.438 | 0.881 | 0.697 | 0.500 | -0.515
debug_20261108_214230_guard_raise_mace.csv | mace | uppercut | guard_raise | 255011 | 255392 | 617.7 | 0.011 | 0.433 | 0.901 | 0.657 | 0.707 | -0.262
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
