leexianhui/CG4002/ai/models/ACTION_FINAL/history.csv

epoch | accuracy | loss | val_accuracy | val_loss | learning_rate
1 | 0.5135714411735535 | 1.3114230632781982 | 0.7894737124443054 | 0.6056737899780273 | 0.0010000000474974513
2 | 0.8366666436195374 | 0.49816685914993286 | 0.8771929740905762 | 0.34670042991638184 | 0.0010000000474974513
3 | 0.9030952453613281 | 0.3040039837360382 | 0.9298245906829834 | 0.25176897644996643 | 0.0010000000474974513
4 | 0.936904788017273 | 0.20890994369983673 | 0.9473684430122375 | 0.20393073558807373 | 0.0010000000474974513
5 | 0.9557142853736877 | 0.1518585979938507 | 0.9473684430122375 | 0.18174462020397186 | 0.0010000000474974513
6 | 0.9669047594070435 | 0.11741171777248383 | 0.9473684430122375 | 0.16813252866268158 | 0.0010000000474974513
7 | 0.9740476012229919 | 0.09441632777452469 | 0.9473684430122375 | 0.16011010110378265 | 0.0010000000474974513
8 | 0.9811905026435852 | 0.07734759896993637 | 0.9473684430122375 | 0.16150584816932678 | 0.0010000000474974513
9 | 0.9847618937492371 | 0.06445109844207764 | 0.9473684430122375 | 0.15699660778045654 | 0.0010000000474974513
10 | 0.988095223903656 | 0.05533621087670326 | 0.9473684430122375 | 0.15325921773910522 | 0.0010000000474974513
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
