leexianhui/CG4002/comms/firmware/src/main.cpp

// CG4002 Comms demo firmware — FireBeetle ESP32, BLE GATT device role.
//
// Speaks the real wire protocol (shared/protocol/wire_protocol.md) to an unmodified cg-relay over
// BLE, generating synthetic sensor data in place of real IMU/RFID hardware (this is a Comms-subsystem
// demo, not the team's real wrist/belt firmware — see comms/firmware/README.md).
//
// Flow: advertise BLE -> laptop connects & subscribes -> HELLO/HELLO_ACK -> 8x TIME_SYNC burst ->
// stream SENSOR_FRAME @50Hz + HEARTBEAT @1Hz, fire RFID_EVENT on button press, ACK incoming
// COMBAT_FEEDBACK. Mirrors comms/src/cg_comms/mock/firebeetle_sim.py's device-side behavior.

#include <Arduino.h>
#include <BLE2902.h>
#include <BLEDevice.h>
#include <BLEServer.h>
#include <BLEUtils.h>

#ifdef CG_HARDWARE_GATEWAY
#include "gateway_config.h"
#include "gateway_boundary.h"
#include "gateway_segments.h"
#include "gateway_link.h"
#include "gateway_log.h"
#include <esp_coexist.h>
#else
#include "cg_config.h"
#endif
#include "cg_frame.h"
#include "cg_protocol.h"
#include "cg_sequence.h"
#include "cg_reliable.h"
#include <freertos/FreeRTOS.h>
#include <freertos/queue.h>

namespace {

uint8_t g_psk[CG_PSK_SIZE];
uint32_t g_session_id = 0;
uint32_t g_device_nonce = 0;
CgOutgoingSequenceCounter g_tx_seq;
CgSequenceTracker g_rx_seq;
uint8_t g_weapon_id = 0;  // Weapon.NONE — see comms/src/cg_comms/messages/enums.py WIRE_VALUES

// Motion-trigger capture state (see cg_config.h CG_DEMO_ACTION_BUTTON_*). A capture is atomic: a
// new action-button press while one is already running is ignored, which is what makes one press
// yield exactly one tagged window even on a double-tap.
uint32_t g_capture_remaining = 0;
uint8_t g_capture_trigger_id = 0;

// Reliable retries keep identical authenticated ciphertext, sequence and nonce.
// A duplicate is ACKed again but never applied twice on either side.
CgReliableSend g_pending_rfid;
#ifdef CG_HARDWARE_GATEWAY
// Hub: the newest guard edge (GUARD_EVENT), ACK + identical-ciphertext retry like RFID_EVENT.
CgReliableSend g_pending_guard;
constexpr uint32_t kGuardMaxAgeMs = 1000; // an edge older than this (relay was away) is stale
// Hub: the newest weapon-candidate edge (WEAPON_CANDIDATE), same delivery as GUARD_EVENT.
CgReliableSend g_pending_candidate;
#endif
CgReliableReceiveCache g_feedback_cache;

#if defined(CG_HARDWARE_GATEWAY) && CG_GATEWAY_EVENT_MODE
// Event-mode uplink (wire_protocol.md §3 SEGMENT_CHUNK). One segment at a time; up to
// kSegmentWindow of its chunks unACKed, each retried with identical ciphertext. Runs on the BLE task.
#define CG_SEGMENT_UPLINK 1
constexpr unsigned kSegmentWindow = 4;
constexpr uint32_t kSegmentChunkTimeoutMs = 150; // first retry; doubles, five sends in all (~2.3 s)
constexpr uint32_t kSegmentMaxQueuedMs = 1500;   // an action older than this is not worth sending
CgReliableSend g_segment_tx[kSegmentWindow];
const GatewaySegment *g_segment = nullptr;
int g_segment_slot = -1;
uint8_t g_segment_next_chunk = 0, g_segment_chunks = 0;
uint32_t g_segment_started_ms = 0;
#endif

#ifndef CG_HARDWARE_GATEWAY
const uint8_t kActionButtonPins[CG_DEMO_ACTION_BUTTON_COUNT] = CG_DEMO_ACTION_BUTTON_PINS;
const uint8_t kActionButtonTriggerIds[CG_DEMO_ACTION_BUTTON_COUNT] = CG_DEMO_ACTION_BUTTON_TRIGGER_IDS;

// Debounced edge detector shared by the weapon button and every action button. `down` is the
// debounce-confirmed state; a falling edge is reported at most once per confirmed transition.
struct DebouncedButton {
    uint8_t pin;
    bool raw_down = false;
    bool down = false;
    uint32_t last_change_ms = 0;
};

DebouncedButton g_weapon_button;
DebouncedButton g_action_buttons[CG_DEMO_ACTION_BUTTON_COUNT];

// Returns true exactly once per debounced falling edge (button just went down).
bool debounce_falling_edge(DebouncedButton *btn, uint32_t now) {
    bool raw = digitalRead(btn->pin) == LOW;
    if (raw != btn->raw_down) {
        btn->raw_down = raw;
        btn->last_change_ms = now;
        return false;
    }
    if (raw != btn->down && (now - btn->last_change_ms) >= CG_DEMO_BUTTON_DEBOUNCE_MS) {
        bool falling_edge = raw && !btn->down;
        btn->down = raw;
        return falling_edge;
    }
    return false;
}

#endif
BLECharacteristic *g_notify_char = nullptr;
BLE2902 *g_notify_cccd = nullptr;  // read to tell whether the relay has subscribed yet
volatile bool g_connected = false;
volatile bool g_handshake_done = false;
volatile uint32_t g_connection_generation = 0;
// BLE callbacks and loop() run on different FreeRTOS tasks/cores. Protect the
// generation check AND handshake-state store; volatile alone cannot make them atomic.
portMUX_TYPE g_connection_mux = portMUX_INITIALIZER_UNLOCKED;
#ifdef CG_HARDWARE_GATEWAY
// The hub is also the central of its torso/left-wrist links, and Bluedroid reports those connections
// to this GATT server too (BLEServer even adds them to its notify list). Only the connection where we
// are the peripheral is the relay: track it, and notify it alone.
volatile int g_relay_conn_id = -1;
esp_gatt_if_t g_gatts_if = ESP_GATT_IF_NONE;
void capture_gatts_if(esp_gatts_cb_event_t event, esp_gatt_if_t gatts_if, esp_ble_gatts_cb_param_t *) {
    if (event == ESP_GATTS_REG_EVT) g_gatts_if = gatts_if;
}
constexpr uint8_t kLinkRolePeripheral = 1; // esp_gatts_api.h: master = 0, slave = 1
#endif

// BLECharacteristic::notify() returns void: on a controller-level failure it logs
// "esp_ble_gatts_send_notify: rc=-1" and returns, so a caller that just calls notify() cannot tell
// a delivered frame from a discarded one. The status callback below is invoked synchronously from
// inside notify() (BLECharacteristic.cpp), so reading this flag immediately after the call reports
// that send's real outcome. Without it send_packet() reported success for frames Bluedroid dropped on
// the chip, which is what made a 50 Hz stream that never left the radio look healthy on serial
// while the relay saw only a fraction of the frames (2026-09-20 span-suppression investigation).
volatile bool g_last_notify_ok = false;

class NotifyStatusCallback : public BLECharacteristicCallbacks {
    void onStatus(BLECharacteristic *characteristic, Status status, uint32_t code) override {
        g_last_notify_ok = (status == Status::SUCCESS_NOTIFY);
    }
};

// FreeRTOS queue copies writes atomically between the BLE callback and Arduino loop (it replaced a
// single mutable slot that overwrote unread ACK/feedback during bursts).
struct IncomingFrame {
    uint8_t data[CG_MAX_FRAME_SIZE];
    size_t len = 0;
};
QueueHandle_t g_incoming_queue = nullptr;
volatile uint32_t g_rx_dropped = 0;
uint32_t g_notify_dropped = 0;

uint8_t hex_nibble(char c) {
    if (c >= '0' && c <= '9') return (uint8_t)(c - '0');
    if (c >= 'a' && c <= 'f') return (uint8_t)(c - 'a' + 10);
    if (c >= 'A' && c <= 'F') return (uint8_t)(c - 'A' + 10);
    return 0;
}

void hex_to_bytes(const char *hex, uint8_t *out, size_t out_len) {
    for (size_t i = 0; i < out_len; i++) {
        out[i] = (uint8_t)((hex_nibble(hex[i * 2]) << 4) | hex_nibble(hex[i * 2 + 1]));
    }
}

class WriteCallback : public BLECharacteristicCallbacks {
    void onWrite(BLECharacteristic *characteristic) override {
        std::string value = characteristic->getValue();
        if (value.length() > CG_MAX_FRAME_SIZE) {
            return;  // oversized — not a valid frame, drop silently like a bad-length decode
        }
        IncomingFrame incoming;
        memcpy(incoming.data, value.data(), value.length());
        incoming.len = value.length();
        if (xQueueSend(g_incoming_queue, &incoming, 0) != pdTRUE) g_rx_dropped++;

    }
};

class ServerCallbacks : public BLEServerCallbacks {
    void relay_connected() {
        portENTER_CRITICAL(&g_connection_mux);
        g_connection_generation++;
        g_connected = true;
        g_handshake_done = false;
        portEXIT_CRITICAL(&g_connection_mux);
        Serial.println("[ble] connected");
    }
#ifndef CG_HARDWARE_GATEWAY
    void onConnect(BLEServer *server) override { relay_connected(); }
#endif
    // Windows picks the connection interval when we don't ask, and its default (~30-45ms) cannot
    // drain a 50Hz (20ms) stream — each interval carries fewer frames than we produce, Bluedroid's
    // tx buffer backs up, and notify() starts failing with rc=-1. Two peripherals sharing one
    // adapter halves the per-link budget again, which is why whichever board connects first (and
    // so streams for longer before the second arrives) shows it worst. Request 7.5-15ms: a
    // peripheral-initiated L2CAP connection-parameter-update, which Windows honours far more often
    // than the passive advertising hint. Only a request — the central may refuse or pick another
    // value, hence the stall counters in send_sensor_frame() rather than trusting it took.
    void onConnect(BLEServer *server, esp_ble_gatts_cb_param_t *param) override {
#ifdef CG_HARDWARE_GATEWAY
        if (param->connect.link_role != kLinkRolePeripheral) return; // a node link, not the relay
        g_relay_conn_id = param->connect.conn_id;
        relay_connected();
        // The hub's one radio is shared with the torso/left-wrist links (BLE, or Wi-Fi in UDP
        // builds). 7.5 ms connection events starved them (nodes went unheard, LEDs stayed yellow).
        // 15-30 ms still carries the 50 Hz stream: frames are batched per connection event.
        server->updateConnParams(param->connect.remote_bda, 0x0C, 0x18, 0, 400);
#else
        server->updateConnParams(param->connect.remote_bda, 0x06, 0x0C, 0, 400);
#endif
    }
#ifdef CG_HARDWARE_GATEWAY
    // A segment chunk is 234 bytes on the wire; below a 237-byte ATT MTU notify() truncates it.
    void onMtuChanged(BLEServer *server, esp_ble_gatts_cb_param_t *param) override {
        if (param->mtu.conn_id != g_relay_conn_id) return;
        Serial.printf("[ble] mtu=%u%s\n", (unsigned)param->mtu.mtu,
                      param->mtu.mtu < 237 ? " (too small for segment chunks)" : "");
    }
#endif
    void relay_disconnected(BLEServer *server) {
        portENTER_CRITICAL(&g_connection_mux);
        g_connection_generation++;
        g_connected = false;
        g_handshake_done = false;
        portEXIT_CRITICAL(&g_connection_mux);
        // Bluedroid does not clear the CCCD itself for a non-bonded central, so a stale "subscribed"
        // value would survive into the next connection and re-open the race this gate closes.
        if (g_notify_cccd != nullptr) {
            g_notify_cccd->setNotifications(false);
        }
        Serial.println("[ble] disconnected, advertising again");
        server->startAdvertising();
    }
#ifdef CG_HARDWARE_GATEWAY
    void onDisconnect(BLEServer *server, esp_ble_gatts_cb_param_t *param) override {
        if (param->disconnect.link_role != kLinkRolePeripheral) return;
        g_relay_conn_id = -1;
        relay_disconnected(server);
    }
#else
    void onDisconnect(BLEServer *server) override { relay_disconnected(server); }
#endif
};

void ble_setup() {
    g_incoming_queue = xQueueCreate(16, sizeof(IncomingFrame));
    configASSERT(g_incoming_queue != nullptr);
#ifdef CG_HARDWARE_GATEWAY
    // The hub runs the hardware algorithms too (and Wi-Fi in UDP node-link builds), and
    // BLEDevice::createServer() ran out of heap. Only BLE is used, so hand back the Classic-BT
    // controller memory (allowed only before init).
    esp_bt_controller_mem_release(ESP_BT_MODE_CLASSIC_BT);
    Serial.printf("[ble] free heap before init: %u (largest block %u)\n",
                  (unsigned)ESP.getFreeHeap(), (unsigned)ESP.getMaxAllocHeap());
#endif
    BLEDevice::init(CG_DEMO_BLE_DEVICE_NAME);
#ifdef CG_HARDWARE_GATEWAY
    BLEDevice::setMTU(247); // room for a 234-byte SEGMENT_CHUNK; the central still has to agree
    BLEDevice::setCustomGattsHandler(capture_gatts_if); // set before createServer() registers the app
#endif
    BLEServer *server = BLEDevice::createServer();
    server->setCallbacks(new ServerCallbacks());
    BLEService *service = server->createService(CG_DEMO_BLE_SERVICE_UUID);

    g_notify_char = service->createCharacteristic(
        CG_DEMO_BLE_NOTIFY_CHAR_UUID, BLECharacteristic::PROPERTY_NOTIFY);
    g_notify_char->setCallbacks(new NotifyStatusCallback());
    g_notify_cccd = new BLE2902();
    g_notify_char->addDescriptor(g_notify_cccd);

    BLECharacteristic *write_char = service->createCharacteristic(
        CG_DEMO_BLE_WRITE_CHAR_UUID, BLECharacteristic::PROPERTY_WRITE_NR | BLECharacteristic::PROPERTY_WRITE);
    write_char->setCallbacks(new WriteCallback());

    service->start();
    BLEAdvertising *advertising = BLEDevice::getAdvertising();
    advertising->addServiceUUID(CG_DEMO_BLE_SERVICE_UUID);
#if defined(CG_HARDWARE_GATEWAY) && !CG_GATEWAY_NODE_LINK
    // One 2.4 GHz radio is time-shared between BLE and the node Wi-Fi. Keep coexistence BALANCED
    // (the IDF default): PREFER_BT starved Wi-Fi so the hub stopped hearing the torso/left wrist.
    esp_coex_preference_set(ESP_COEX_PREFER_BALANCE);
#endif
    advertising->start();
#ifdef CG_HARDWARE_GATEWAY
    Serial.printf("[ble] free heap after init: %u (largest block %u)\n",
                  (unsigned)ESP.getFreeHeap(), (unsigned)ESP.getMaxAllocHeap());
#if CG_GATEWAY_NODE_LINK
    gatewayHubLinkBegin(); // central to this player's torso and left wrist, alongside the relay
#endif
#endif
}

// SUCCESS_NOTIFY means accepted by Bluedroid, NOT delivery over the air.
bool notify_frame(const uint8_t *frame, size_t frame_len) {
#ifdef CG_HARDWARE_GATEWAY
    // Straight to the relay's connection: BLECharacteristic::notify() would also send to the nodes.
    int conn = g_relay_conn_id;
    g_last_notify_ok = conn >= 0 && g_gatts_if != ESP_GATT_IF_NONE &&
                       esp_ble_gatts_send_indicate(g_gatts_if, (uint16_t)conn, g_notify_char->getHandle(),
                                                   frame_len, (uint8_t *)frame, false) == ESP_OK;
#else
    g_notify_char->setValue((uint8_t *)frame, frame_len);
    g_last_notify_ok = false;
    g_notify_char->notify();
#endif
    if (!g_last_notify_ok) g_notify_dropped++;
    return g_last_notify_ok;
}

// Encoding always consumes a fresh sequence. Reliable retries reuse these bytes, never reseal.
bool send_packet(uint8_t packet_type, const uint8_t *plaintext, size_t plaintext_len,
                  const uint8_t *cleartext_prefix, size_t cleartext_prefix_len,
                  uint16_t *wire_seq_out = nullptr, CgReliableSend *pending = nullptr) {
    uint32_t ext_seq;
    uint16_t seq = g_tx_seq.next(&ext_seq);
    uint32_t nonce_base = (packet_type == CG_PKT_HELLO) ? g_device_nonce : g_session_id;

    uint8_t frame[CG_MAX_FRAME_SIZE];
    size_t frame_len = cg_encode_frame(packet_type, seq, CG_DEMO_PLAYER_ID, plaintext, plaintext_len,
                                        cleartext_prefix, cleartext_prefix_len, g_psk, nonce_base,
                                        CG_DIR_DEVICE_TO_LAPTOP, ext_seq, frame);
    if (frame_len == 0) {
        return false;
    }
    if (wire_seq_out != nullptr) *wire_seq_out = seq;
    if (packet_type == CG_PKT_RFID_EVENT)
        g_pending_rfid.begin(frame, frame_len, seq, millis());
    if (pending != nullptr) pending->begin(frame, frame_len, seq, millis());
    return notify_frame(frame, frame_len);
}

// Blocks (with a timeout) until a frame of `expect_type` decodes successfully from the laptop.
// Returns true and fills plaintext_out/plaintext_len_out on success.
bool wait_for_packet(uint8_t expect_type, uint8_t *plaintext_out, size_t plaintext_cap,
                      size_t *plaintext_len_out, uint32_t timeout_ms) {
    uint32_t deadline = millis() + timeout_ms;
    uint32_t generation = g_connection_generation;
    while (g_connected && generation == g_connection_generation && (int32_t)(deadline - millis()) > 0) {
        IncomingFrame incoming;
        if (xQueueReceive(g_incoming_queue, &incoming, 0) == pdTRUE) {
            bool is_handshake = (expect_type == CG_PKT_HELLO_ACK);
            uint32_t nonce_base = is_handshake ? g_device_nonce : g_session_id;

            uint8_t packet_type, player_id;
            uint16_t seq;
            uint32_t ext_seq;
            // Validate length/CRC/magic/version/fragmentation before touching the replay window —
            // a frame corrupted in transit must never consume a window slot (matches codec.py's
            // check order: CRC/magic/version first, sequence_tracker.accept() only after).
            uint16_t wire_seq;
            if (!cg_frame_precheck(incoming.data, incoming.len, &wire_seq)) {
                continue;
            }
            CgSequenceTracker candidate = g_rx_seq;
            if (!candidate.accept(wire_seq, &ext_seq)) {
                continue;
            }
            size_t plaintext_len = cg_decode_frame(
                incoming.data, incoming.len, is_handshake ? 4 : 0, g_psk, nonce_base,
                CG_DIR_LAPTOP_TO_DEVICE, ext_seq, &packet_type, &seq, &player_id, plaintext_out,
                plaintext_cap);
            if (plaintext_len == 0 || packet_type != expect_type || player_id != CG_DEMO_PLAYER_ID) {
                continue;
            }
            g_rx_seq = candidate;
            *plaintext_len_out = plaintext_len;
            return true;
        }
        delay(2);
    }
    return false;
}

// Sends an ACK for `acked_seq`. Factored out so both the fresh-frame path and the
// already-seen-duplicate path (below) can answer identically — a duplicate must still be ACKed,
// since its arrival means our previous ACK was the packet that actually got lost.
void send_ack_for(uint16_t acked_seq) {
    uint8_t payload[2];  // cg_payload_ack_t
    memcpy(payload, &acked_seq, 2);
    send_packet(CG_PKT_ACK, payload, sizeof(payload), nullptr, 0);
}

uint8_t next_weapon_id() { return (g_weapon_id % 3) + 1; }

void drain_incoming_non_blocking() {
    IncomingFrame incoming;
    // Bound each turn: sensor/button work continues even under incoming bursts.
    for (unsigned i = 0; i < 16 && xQueueReceive(g_incoming_queue, &incoming, 0) == pdTRUE; i++) {
        uint16_t wire_seq;
        if (!cg_frame_precheck(incoming.data, incoming.len, &wire_seq)) continue;
        if (g_feedback_cache.contains(incoming.data, incoming.len, millis())) {
            send_ack_for(wire_seq); // exact previously authenticated COMBAT_FEEDBACK only
            continue;
        }
        CgSequenceTracker candidate = g_rx_seq;
        uint32_t ext_seq;
        bool accepted = candidate.accept(wire_seq, &ext_seq);
        const uint8_t wire_type = incoming.data[2];
        if (wire_type == CG_PKT_COMBAT_FEEDBACK) {
            // Reliable types use a monotonic watermark instead of the 64-wide window, so a first
            // arrival after several lost sends is not mistaken for a replay (mirrors codec.py).
            // wire_type is still unauthenticated here; a forged byte only picks which check is
            // applied, and the GCM check below (header is AAD) rejects the frame either way.
            int64_t inferred = g_rx_seq.infer(wire_seq);
            if (inferred <= g_feedback_cache.highest) continue;
            ext_seq = (uint32_t)inferred;
        } else if (!accepted) continue;
        uint8_t plaintext[CG_MAX_FRAME_SIZE], packet_type, player_id;
        uint16_t seq;
        size_t len = cg_decode_frame(incoming.data, incoming.len, 0, g_psk, g_session_id,
            CG_DIR_LAPTOP_TO_DEVICE, ext_seq, &packet_type, &seq, &player_id, plaintext, sizeof(plaintext));
        if (!len || player_id != CG_DEMO_PLAYER_ID) continue;
        if ((packet_type == CG_PKT_ACK && len != 2) ||
            (packet_type == CG_PKT_COMBAT_FEEDBACK && len != sizeof(cg_payload_combat_feedback_t))) continue;
#ifdef CG_HARDWARE_GATEWAY
        // Do not ACK/cache a command the hardware queue could not accept: let the relay retry.
        if (packet_type == CG_PKT_COMBAT_FEEDBACK && !gatewayQueueFeedback(plaintext)) continue;
#endif
        g_rx_seq = candidate; // commit replay state only after GCM authentication
        if (packet_type == CG_PKT_COMBAT_FEEDBACK) {
            g_feedback_cache.highest = ext_seq;
            g_feedback_cache.remember(incoming.data, incoming.len, millis());
            send_ack_for(seq);
#ifdef CG_HARDWARE_GATEWAY
            gatewayLogf("[feedback] queued seq=%u code=%u\n", (unsigned)seq, (unsigned)plaintext[0]);
#else
            Serial.printf("[feedback] applied seq=%u code=%u\n", (unsigned)seq, (unsigned)plaintext[0]);
#endif
        } else if (packet_type == CG_PKT_ACK) {
            uint16_t acked_seq;
            memcpy(&acked_seq, plaintext, 2);
            bool was_pending = g_pending_rfid.active;
            g_pending_rfid.ack(acked_seq);
            if (was_pending && !g_pending_rfid.active)
                Serial.printf("[weapon] rfid_event acked seq=%u\n", (unsigned)acked_seq);
#ifdef CG_SEGMENT_UPLINK
            for (auto &chunk : g_segment_tx) chunk.ack(acked_seq);
#endif
#ifdef CG_HARDWARE_GATEWAY
            g_pending_candidate.ack(acked_seq);
            bool guard_was_pending = g_pending_guard.active;
            g_pending_guard.ack(acked_seq);
            if (guard_was_pending && !g_pending_guard.active)
                gatewayLogf("[guard] guard_event acked seq=%u\n", (unsigned)acked_seq);
#endif
        }
    }
}

#ifdef CG_SEGMENT_UPLINK
void finish_segment(const char *outcome) {
    if (g_segment == nullptr) return;
    gatewayLogf("[segment] %s seg=%lu samples=%u chunks=%u in %lums\n", outcome,
                  (unsigned long)g_segment->id, (unsigned)g_segment->count, (unsigned)g_segment_chunks,
                  (unsigned long)(millis() - g_segment_started_ms));
    for (auto &chunk : g_segment_tx) chunk.reset();
    gatewaySegmentDone(g_segment_slot);
    g_segment = nullptr;
    g_segment_slot = -1;
}

// Sends the next chunks of the current segment as window slots free up, retries unACKed ones, and
// moves on to the next queued segment once every chunk is ACKed (or one exhausts its retries).
void service_segments() {
    uint32_t now = millis();
    if (g_segment == nullptr) {
        g_segment = gatewaySegmentTake(now, kSegmentMaxQueuedMs, g_segment_slot);
        if (g_segment == nullptr) return;
        g_segment_next_chunk = 0;
        g_segment_chunks = gatewaySegmentChunks(*g_segment);
        g_segment_started_ms = now;
    }
    bool busy = false;
    for (auto &chunk : g_segment_tx) {
        int due = chunk.poll(now);
        if (due < 0) {
            finish_segment("undelivered");
            return;
        }
        if (due > 0) notify_frame(chunk.frame, chunk.len);
        if (!chunk.active && g_segment_next_chunk < g_segment_chunks) {
            cg_payload_segment_chunk_t payload;
            gatewaySegmentChunk(*g_segment, g_segment_next_chunk++, payload);
            send_packet(CG_PKT_SEGMENT_CHUNK, (const uint8_t *)&payload, sizeof(payload), nullptr, 0,
                        nullptr, &chunk);
            chunk.timeout_ms = kSegmentChunkTimeoutMs; // ACKs return within a few connection events
            chunk.next_ms = now + kSegmentChunkTimeoutMs;
        }
        busy |= chunk.active;
    }
    if (!busy && g_segment_next_chunk >= g_segment_chunks) finish_segment("sent");
}
#endif

bool do_handshake() {
    g_tx_seq.reset();
    g_rx_seq.reset();
    g_pending_rfid.reset();
#ifdef CG_HARDWARE_GATEWAY
    g_pending_guard.reset();
    g_pending_candidate.reset();
#endif
#ifdef CG_SEGMENT_UPLINK
    finish_segment("abandoned (relay reconnected)");
#endif
    g_feedback_cache.reset();
    g_capture_remaining = 0;
    g_session_id = 0;
    xQueueReset(g_incoming_queue);
    g_device_nonce = esp_random();
    uint8_t device_mac[6];
    esp_read_mac(device_mac, ESP_MAC_BT);

    // cg_payload_hello_t, little-endian, matches PAYLOAD_TABLES[HELLO] field order exactly.
    uint8_t hello[16];
    memcpy(hello, device_mac, 6);
    hello[6] = CG_DEMO_PLAYER_ID;
    hello[7] = CG_PROTOCOL_VERSION;
    hello[8] = 4;
#ifdef CG_HARDWARE_GATEWAY
    hello[8] = 5; // real hardware boundary, same protocol v1
#endif
    hello[9] = 0;  // firmware_version = 4 (u16 LE): gameplay only, assessment extension removed
    memcpy(hello + 10, &g_device_nonce, 4);
    hello[14] = 0;
    hello[15] = 0;  // reserved

    uint8_t device_nonce_prefix[4];
    memcpy(device_nonce_prefix, &g_device_nonce, 4);

    if (!send_packet(CG_PKT_HELLO, hello, sizeof(hello), device_nonce_prefix, sizeof(device_nonce_prefix))) {
        Serial.println("[handshake] HELLO send failed");
        return false;
    }

    uint8_t ack_plaintext[32];
    size_t ack_len;
    if (!wait_for_packet(CG_PKT_HELLO_ACK, ack_plaintext, sizeof(ack_plaintext), &ack_len, 5000)) {
        Serial.println("[handshake] no HELLO_ACK");
        return false;
    }
    // cg_payload_hello_ack_t: session_id(4) | epoch_lo(4) | epoch_hi(4) | device_nonce_echo(4).
    uint32_t echoed_nonce = 0;
    if (ack_len != 16) return false;
    memcpy(&echoed_nonce, ack_plaintext + 12, 4);
    if (echoed_nonce != g_device_nonce) return false;
    memcpy(&g_session_id, ack_plaintext, 4);
    if (g_session_id == 0) {
        Serial.println("[handshake] refused (version mismatch)");
        return false;
    }
    for (int i = 0; i < 8; i++) {
        uint32_t t0 = millis();
        uint8_t req[4];
        memcpy(req, &t0, 4);
        if (!send_packet(CG_PKT_TIME_SYNC_REQ, req, sizeof(req), nullptr, 0)) {
            Serial.println("[handshake] TIME_SYNC_REQ send failed");
            return false;
        }

        uint8_t resp[16];
        size_t resp_len;
        if (!wait_for_packet(CG_PKT_TIME_SYNC_RESP, resp, sizeof(resp), &resp_len, 2000) ||
            resp_len != 12 || memcmp(resp, &t0, 4) != 0) {
            Serial.println("[handshake] TIME_SYNC_RESP timeout/mismatch");
            return false;
        }
        delay(100);
    }

    Serial.printf("[handshake] complete, session_id=0x%08X\n", g_session_id);
    return true;
}

void send_sensor_frame() {
#ifdef CG_HARDWARE_GATEWAY
    cg_payload_sensor_frame_t frame;
    gatewayReadFrame(frame);
    uint8_t payload[sizeof(frame)];
    memcpy(payload, &frame, sizeof(frame));
#else
    static float phase = 0.0f;
    phase += 0.3f;

    // Synthetic "swing" pattern: sine-wave accel/gyro on the dominant wrist, near-zero elsewhere.
    // Scaling per protocol/constants.py: accel 1 LSB = 1/2048 g, gyro 1 LSB = 1/16.4 deg/s.
    int16_t dominant[6] = {
        (int16_t)(sinf(phase) * 1.5f * 2048.0f), 0, (int16_t)(cosf(phase) * 0.5f * 2048.0f),
        (int16_t)(sinf(phase) * 200.0f * 16.4f), 0, 0,
    };
    int16_t offhand[6] = {0, 0, (int16_t)(1.0f * 2048.0f), 0, 0, 0};
    int16_t torso[6] = {0, 0, (int16_t)(1.0f * 2048.0f), 0, 0, 0};

    uint8_t flags = 0;
    if (g_capture_remaining > 0) {
        flags = CG_FLAG_MOTION_ACTIVE | ((g_capture_trigger_id & 0x7) << CG_FLAG_TRIGGER_ID_SHIFT);
        g_capture_remaining--;
    }

    uint8_t payload[42];
    uint32_t ts = millis();
    memcpy(payload, &ts, 4);
    payload[4] = flags;
    payload[5] = g_weapon_id;
    memcpy(payload + 6, dominant, 12);
    memcpy(payload + 18, offhand, 12);
    memcpy(payload + 30, torso, 12);
#endif

    // Rate-limited to 1 line/sec: at 50 Hz an unthrottled print would flood the monitor and
    // slow the loop. Without this the 50 Hz path is invisible on serial and a soak test looks
    // healthy while only heartbeats are actually flowing.
    //
    // `dropped` counts frames the controller refused (tx buffer full). It is the number that
    // matters: `sent` alone read a flat 50/s while the relay was receiving far fewer, because the
    // frames were being generated on time and discarded on-chip. sent+dropped is the generated
    // rate; `sent` counts stack acceptance only. The relay sees only
    // accepted frames; radio delivery still requires hardware validation.
    static uint32_t last_log_ms = 0;
    static uint32_t sent_since_log = 0;
    static uint32_t dropped_since_log = 0;
    if (send_packet(CG_PKT_SENSOR_FRAME, payload, sizeof(payload), nullptr, 0)) {
        sent_since_log++;
    } else {
        dropped_since_log++;
    }
    uint32_t now = millis();
    if (now - last_log_ms >= 1000) {
        last_log_ms = now;
        Serial.printf("[tx] sensor_frames=%lu/s dropped=%lu/s weapon=%u generated=%lu/s notify_dropped=%lu rx_dropped=%lu\n",
                      (unsigned long)sent_since_log, (unsigned long)dropped_since_log,
                      (unsigned)g_weapon_id, (unsigned long)(sent_since_log + dropped_since_log),
                      (unsigned long)g_notify_dropped, (unsigned long)g_rx_dropped);
        sent_since_log = 0;
        dropped_since_log = 0;
    }
}

void send_heartbeat() {
    Serial.printf("[tx] heartbeat t=%lu\n", (unsigned long)millis());
    uint8_t payload[12];
    uint32_t ts = millis();
    memcpy(payload, &ts, 4);
    uint16_t vbat = 4000, status = 0;
#ifdef CG_HARDWARE_GATEWAY
    vbat = 0; // no battery telemetry is supplied by these sketches; never invent a measurement
#endif
    memcpy(payload + 4, &vbat, 2);
    memcpy(payload + 6, &vbat, 2);
    memcpy(payload + 8, &vbat, 2);
    memcpy(payload + 10, &status, 2);
    send_packet(CG_PKT_HEARTBEAT, payload, sizeof(payload), nullptr, 0);
}

// Weapon wire values per comms/src/cg_comms/messages/enums.py WIRE_VALUES: NONE=0 SWORD=1 SPEAR=2 MACE=3.
void send_current_weapon() {
    if (g_weapon_id == 0) return;
    uint8_t payload[12];
    uint32_t ts = millis();
    memcpy(payload, &ts, 4);
    payload[4] = g_weapon_id;
    payload[5] = 0;
    uint8_t uid[6] = {0xE0, 0x04, 0x01, 0x50, CG_DEMO_PLAYER_ID, g_weapon_id};
#ifdef CG_HARDWARE_GATEWAY
    memset(uid, 0, sizeof(uid)); // posture-derived selection, no physical RFID tag
#endif
    memcpy(payload + 6, uid, 6);
    // A new selection supersedes the pending old selection, including its ACK identity.
    bool accepted = send_packet(CG_PKT_RFID_EVENT, payload, sizeof(payload), nullptr, 0);
    Serial.printf("[weapon] now %u seq=%u accepted=%u\n",
                  (unsigned)g_weapon_id, (unsigned)g_pending_rfid.seq, (unsigned)accepted);
}

void send_rfid_event_next_weapon() {
    g_weapon_id = next_weapon_id();
    send_current_weapon();
}

void service_pending_rfid_event() {
    int due = g_pending_rfid.poll(millis());
    if (due < 0) {
        Serial.printf("[weapon] rfid_event undelivered after 5 attempts, wire_seq=%u\n",
                      (unsigned)g_pending_rfid.seq);
    } else if (due > 0) {
        bool accepted = notify_frame(g_pending_rfid.frame, g_pending_rfid.len);
        Serial.printf("[weapon] rfid_event retransmit attempt=%u wire_seq=%u accepted=%u\n",
                      (unsigned)g_pending_rfid.attempts, (unsigned)g_pending_rfid.seq, (unsigned)accepted);
    }
}

#ifdef CG_HARDWARE_GATEWAY
// Hub: forwards the left wrist's newest guard edge to the relay as a reliable GUARD_EVENT. A newer
// edge supersedes an unACKed older one; an edge that waited out a relay outage is dropped.
void service_guard_events() {
    uint8_t state;
    uint32_t event_ms;
    if (gatewayTakeGuardEvent(state, event_ms)) {
        uint32_t age = millis() - event_ms;
        if (age > kGuardMaxAgeMs) {
            gatewayLogf("[guard] dropped stale edge state=%u age=%lums\n", (unsigned)state,
                        (unsigned long)age);
        } else {
            cg_payload_guard_event_t payload = {};
            payload.device_timestamp_ms = event_ms;
            payload.guard_state = state;
            payload.weapon_id = g_weapon_id;
            bool accepted = send_packet(CG_PKT_GUARD_EVENT, (const uint8_t *)&payload, sizeof(payload),
                                        nullptr, 0, nullptr, &g_pending_guard);
            gatewayLogf("[guard] guard_event %s seq=%u accepted=%u\n", state ? "GUARDING" : "IDLE",
                        (unsigned)g_pending_guard.seq, (unsigned)accepted);
        }
    }
    int due = g_pending_guard.poll(millis());
    if (due < 0)
        gatewayLogf("[guard] guard_event undelivered after 5 attempts, seq=%u\n",
                    (unsigned)g_pending_guard.seq);
    else if (due > 0)
        notify_frame(g_pending_guard.frame, g_pending_guard.len);
}

// Hub: forwards hardware debug-log pieces (its own and its nodes', gateway_log.h) to the relay as
// best-effort DEVICE_LOG packets. Lowest priority: never while a segment is going out, and at most
// one piece per kLogIntervalMs (~4 KB/s), so logging cannot crowd out gameplay traffic.
constexpr uint32_t kLogIntervalMs = 20;
void service_device_logs() {
    static uint32_t last_ms = 0, last_drop_report_ms = 0;
    uint32_t now = millis();
    if (now - last_drop_report_ms >= 1000) {
        last_drop_report_ms = now;
        uint32_t dropped = gatewayLogTakeDropped();
        if (dropped) gatewayLogf("[log] dropped %lu pieces (queue full)\n", (unsigned long)dropped);
    }
#ifdef CG_SEGMENT_UPLINK
    if (g_segment != nullptr) return;
#endif
    if (now - last_ms < kLogIntervalMs) return;
    cg_payload_device_log_t piece;
    if (!gatewayLogTake(piece)) return;
    last_ms = now;
    send_packet(CG_PKT_DEVICE_LOG, (const uint8_t *)&piece, sizeof(piece), nullptr, 0);
}

// Hub: forwards the newest weapon-candidate edge (lock-in started / stopped) as a reliable
// WEAPON_CANDIDATE, for the phones' lock-in countdown. Stale edges (relay away) are dropped.
void service_weapon_candidate() {
    uint8_t weapon;
    uint32_t event_ms;
    uint16_t lock_ms;
    if (gatewayTakeWeaponCandidate(weapon, event_ms, lock_ms) && millis() - event_ms <= kGuardMaxAgeMs) {
        cg_payload_weapon_candidate_t payload = {};
        payload.device_timestamp_ms = event_ms;
        payload.weapon_id = weapon;
        payload.lock_ms = lock_ms;
        send_packet(CG_PKT_WEAPON_CANDIDATE, (const uint8_t *)&payload, sizeof(payload), nullptr, 0,
                    nullptr, &g_pending_candidate);
    }
    if (g_pending_candidate.poll(millis()) > 0)
        notify_frame(g_pending_candidate.frame, g_pending_candidate.len);
}
#endif

}  // namespace

void setup() {
#ifndef CG_HARDWARE_GATEWAY
    Serial.begin(115200);
#endif
    hex_to_bytes(CG_DEMO_PSK_HEX, g_psk, CG_PSK_SIZE);
#ifndef CG_HARDWARE_GATEWAY
    pinMode(CG_DEMO_WEAPON_BUTTON_PIN, INPUT_PULLUP);
    g_weapon_button.pin = CG_DEMO_WEAPON_BUTTON_PIN;
    for (int i = 0; i < CG_DEMO_ACTION_BUTTON_COUNT; i++) {
        pinMode(kActionButtonPins[i], INPUT_PULLUP);
        g_action_buttons[i].pin = kActionButtonPins[i];
    }
#endif
    ble_setup();
    Serial.println("[boot] advertising, waiting for relay connection");
}

void loop() {
    static uint32_t last_sensor_ms = 0;
    static uint32_t last_heartbeat_ms = 0;
#ifdef CG_HARDWARE_GATEWAY
    gatewayLinkService();
    uint8_t weapon = gatewayWeapon();
    if (weapon != g_weapon_id) {
        g_weapon_id = weapon;
        if (g_handshake_done) send_current_weapon();
    }
#endif

    if (!g_connected) {
        delay(50);
        return;
    }
    // A BLE connection alone does not mean the relay can hear us: transport/ble.py calls
    // start_notify() only after client.connect() returns, so a HELLO sent in that gap is notified
    // into a void and the handshake burns its full 5s HELLO_ACK timeout before retrying. Wait for
    // the central to write the CCCD (which is what start_notify does) before speaking.
    if (g_notify_cccd == nullptr || !g_notify_cccd->getNotifications()) {
        delay(10);
        return;
    }
    if (!g_handshake_done) {
        static bool announced = false;
        if (!announced) {
            Serial.println("[ble] relay subscribed, starting handshake");
            announced = true;
        }
        uint32_t generation = g_connection_generation;
        bool completed = do_handshake();
        portENTER_CRITICAL(&g_connection_mux);
        g_handshake_done = completed && g_connected && generation == g_connection_generation;
        portEXIT_CRITICAL(&g_connection_mux);
        if (g_handshake_done) send_current_weapon(); // reannounce held selection after BLE/relay restart
        if (!g_handshake_done) {
            announced = false;
            delay(1000);  // let the relay retry its own reconnect loop rather than spamming HELLOs
        }
        return;
    }

    uint32_t now = millis();
#ifdef CG_SEGMENT_UPLINK
    // Event mode: no periodic SENSOR_FRAME; accepted segments go out in service_segments() below.
    (void)last_sensor_ms;
#else
    if (now - last_sensor_ms >= CG_DEMO_SENSOR_FRAME_INTERVAL_MS) {
        // Absolute-deadline pacing: advance by exactly one interval rather than snapping to `now`,
        // so loop jitter (BLE notify, Serial) does not accumulate into a lower average rate -- the
        // relay's span gate assumes 50 Hz, and "last = now" silently loses ~1 ms per frame. If we
        // fell more than one interval behind (reconnect, long notify stall), resync instead of
        // bursting the backlog: a burst would overrun the notify queue and show up as loss.
        last_sensor_ms += CG_DEMO_SENSOR_FRAME_INTERVAL_MS;
        if (now - last_sensor_ms >= CG_DEMO_SENSOR_FRAME_INTERVAL_MS) last_sensor_ms = now;
        send_sensor_frame();
    }
#endif
    if (now - last_heartbeat_ms >= CG_DEMO_HEARTBEAT_INTERVAL_MS) {
        last_heartbeat_ms = now;
        send_heartbeat();
    }

#ifndef CG_HARDWARE_GATEWAY
    if (debounce_falling_edge(&g_weapon_button, now)) {
        send_rfid_event_next_weapon();
    }
    for (int i = 0; i < CG_DEMO_ACTION_BUTTON_COUNT; i++) {
        if (debounce_falling_edge(&g_action_buttons[i], now)) {
            // A press during an active capture is ignored — the capture is atomic (§3.2), so a
            // double-tap still yields exactly one window.
            if (g_capture_remaining == 0) {
                g_capture_remaining = CG_DEMO_CAPTURE_FRAMES;
                g_capture_trigger_id = kActionButtonTriggerIds[i];
                Serial.printf("[capture] start trigger_id=%u frames=%lu\n",
                              (unsigned)g_capture_trigger_id, (unsigned long)g_capture_remaining);
            }
        }
    }

#endif
    drain_incoming_non_blocking();
    service_pending_rfid_event();
#ifdef CG_HARDWARE_GATEWAY
    service_guard_events();
    service_weapon_candidate();
#endif
#ifdef CG_SEGMENT_UPLINK
    service_segments();
#endif
#ifdef CG_HARDWARE_GATEWAY
    service_device_logs();
#endif
}
