leexianhui/CG4002/cg4002-hw-main/speed_study.py

"""Speed study: is the valid-action check biased against slow swings, and
which features stay the same across speeds while still separating real
strikes from fakes?

    python speed_study.py [--logs "2 players/logs"] [--out figures/speed_study]
    python speed_study.py --old-logs "2 players/logs/p1_v1" \
        --new-logs "2 players/logs/p1"

Needs RAW_STREAM sessions (raw_<time>_<action>_<slow|normal|fast>.csv) plus
their debug CSVs. See figpipe/raw.py for how strokes and features are found.
Writes figures, CSV tables and a README into --out. When --old-logs and
--new-logs are supplied, they explicitly identify the firmware generation;
otherwise the timestamp cutoff below is used for backwards compatibility.
"""

import argparse
import os

import numpy as np
import pandas as pd
from sklearn.linear_model import LogisticRegression
from sklearn.metrics import roc_auc_score
from sklearn.pipeline import make_pipeline
from sklearn.preprocessing import StandardScaler

from figpipe import replay as R
from figpipe import style as S
from figpipe.logs import REAL_ACTIONS
from figpipe.raw import PROFILE_POINTS, build_table, firmware_strokes

SKETCH = os.path.join("2 players", "p1_right_wrist", "p1_right_wrist.ino")
SPEEDS = ["slow", "normal", "fast"]
SPEED_COLOR = {"slow": S.SEQ_BLUE[2], "normal": S.SEQ_BLUE[6], "fast": S.SEQ_BLUE[11]}

MAGNITUDE = ["peak_gyro", "peak_jerk", "stroke_ms", "torso_peak"]
INVARIANT = ["rot_deg", "straightness", "peak_pos", "sustain", "reversals_rel", "n_peaks", "windup",
             "r_eff", "jerk_per_rot", "torso_rot", "torso_ratio", "torso_lag", "template_corr"]
FEATURE_NAME = {
    "peak_gyro": "peak gyro (dps)", "peak_jerk": "peak jerk (g)", "stroke_ms": "stroke duration (ms)",
    "torso_peak": "torso peak (dps)", "rot_deg": "rotation angle (deg)", "straightness": "straightness",
    "peak_pos": "peak position", "sustain": "half-peak width", "reversals_rel": "reversals (rel.)",
    "n_peaks": "peaks > 0.5", "windup": "wind-up", "r_eff": "effective radius", "jerk_per_rot": "jerk per rotation",
    "torso_rot": "torso rotation (deg)", "torso_ratio": "torso ÷ wrist rotation", "torso_lag": "torso lag",
    "template_corr": "template correlation",
}
LR_FEATURES = ["rot_deg", "straightness", "sustain", "reversals_rel", "n_peaks", "r_eff", "torso_ratio",
               "template_corr"]

# Direction rule: the stroke's rotation axis matches an action's strike axis
# (fixed by how the board is strapped on), its rotation angle sits in that
# action's range, and the torso isn't carrying the motion (body turn).
DIR_COS_MIN = 0.8
DIR_ROT_MARGIN = 0.10
DIR_ROT_PCT = (5, 95)
AXIS = ["axis_x", "axis_y", "axis_z"]


def fit_direction(tr):
    model = {}
    for act in REAL_ACTIONS:
        s = tr[(tr.label == act) & (tr.y == 1)]
        if len(s) < 3:
            continue
        V = s[AXIS].to_numpy()
        if act == "spin":  # spun both ways
            V = V * np.sign(V @ V[0])[:, None]
        c = V.mean(0)
        lo, hi = np.percentile(s.rot_deg, DIR_ROT_PCT)
        tmax = np.percentile(s.torso_ratio.dropna(), 95)
        model[act] = (c / np.linalg.norm(c), lo * (1 - DIR_ROT_MARGIN), hi * (1 + DIR_ROT_MARGIN),
                      max(1.5 * tmax, 0.3))
    return model


def predict_direction(model, te):
    out = np.zeros(len(te), bool)
    V = te[AXIS].to_numpy()
    for act, (c, lo, hi, tmax) in model.items():
        cs = V @ c
        if act == "spin":
            cs = np.abs(cs)
        out |= ((cs >= DIR_COS_MIN) & te.rot_deg.between(lo, hi).to_numpy()
                & ~(te.torso_ratio.to_numpy() > tmax))
    return out


def add_template_corr(df):
    """Best correlation of a stroke's normalised profile with any action's mean
    strike profile. A strike is only compared with templates built from the
    OTHER speeds, so a high score means the shape carries across speeds."""
    P = np.vstack(df["_profile"].to_numpy())
    strikes = (df.role == "strike") & ~df.has_gap
    out = np.full(len(df), np.nan)
    for i in range(len(df)):
        best = -1.0
        for act in REAL_ACTIONS:
            m = strikes & (df.label == act)
            if df.role.iat[i] == "strike":
                m &= df.speed != df.speed.iat[i]
            if m.sum() < 3:
                continue
            tpl = P[m.to_numpy()].mean(0)
            best = max(best, float(np.corrcoef(P[i], tpl)[0, 1]))
        out[i] = best
    df["template_corr"] = out
    return df


def groups(df):
    ok = ~df.has_gap
    return (df[ok & (df.role == "strike")], df[ok & (df.cls == "fake")], df[ok & (df.role == "return")])


# ------------------------------------------------------------- bias

def bias_tables(df):
    st = df[df.role == "strike"]
    rate = (st.groupby(["label", "speed"]).agg(n=("fw_accept", "size"), accepted=("fw_accept", "sum"))
            .reindex(pd.MultiIndex.from_product([REAL_ACTIONS, SPEEDS], names=["label", "speed"])))
    rate["rate"] = rate.accepted / rate.n
    rej = st[~st.fw_accept].explode("fw_fails")
    fails = rej.groupby(["speed", "fw_fails"]).size().unstack("speed", fill_value=0).reindex(columns=SPEEDS,
                                                                                             fill_value=0)
    n_rej = st[~st.fw_accept].groupby("speed").size().reindex(SPEEDS, fill_value=0)
    trim = st[~st.has_gap].groupby(["label", "speed"]).trim_cov.median().unstack("speed").reindex(
        index=REAL_ACTIONS, columns=SPEEDS)
    dur = st.groupby(["label", "speed"]).stroke_ms.median().unstack("speed").reindex(index=REAL_ACTIONS,
                                                                                       columns=SPEEDS)
    neg = df[(df.cls == "fake") | (df.role == "return")]
    fp = neg.groupby(neg.cls.where(neg.cls == "fake", "return")).fw_accept.agg(["size", "sum"])
    return rate, fails, n_rej, trim, dur, fp


def fig_bias(rate, out):
    fig, ax = S.new_fig()
    fig.subplots_adjust(left=0.07, right=0.98, top=0.80, bottom=0.12)
    x = np.arange(len(REAL_ACTIONS))
    wdt = 0.27
    for k, sp in enumerate(SPEEDS):
        r = rate.xs(sp, level="speed").reindex(REAL_ACTIONS)
        bars = ax.bar(x + (k - 1) * wdt, 100 * r.rate.fillna(0), wdt * 0.92, color=SPEED_COLOR[sp], label=sp)
        for b, (acc, n) in zip(bars, zip(r.accepted, r.n)):
            if pd.notna(n):
                ax.text(b.get_x() + b.get_width() / 2, b.get_height() + 1.5, f"{int(acc)}/{int(n)}",
                        ha="center", va="bottom", fontsize=14, color=S.INK_2)
    ax.set_xticks(x, REAL_ACTIONS)
    ax.set_ylabel("Real strikes accepted (%)")
    ax.set_ylim(0, 115)
    ax.legend(loc="lower left", bbox_to_anchor=(0, 1.0), ncol=3)
    fig.suptitle("The current check accepts fast strikes and rejects slow ones", x=0.012, y=0.975, ha="left",
                 fontsize=28, fontweight="bold", color=S.INK)
    S.footnote(fig, "Firmware decisions logged live (2026-10-04, player 1, sword & shield). "
                    "One bar = one session of ~10 reps. No fake movement was accepted at any speed.")
    return S.save(fig, out, "01_accept_rate_by_speed")


def fig_fail_reasons(fails, n_rej, out):
    fig, ax = S.new_fig()
    fig.subplots_adjust(left=0.20, right=0.97, top=0.80, bottom=0.12)
    order = fails.sum(1).sort_values().index
    y = np.arange(len(order))
    h = 0.27
    for k, sp in enumerate(SPEEDS):
        share = 100 * fails.loc[order, sp] / max(n_rej[sp], 1)
        ax.barh(y + (k - 1) * h, share, h * 0.92, color=SPEED_COLOR[sp], label=f"{sp} ({n_rej[sp]} rejected)")
    ax.set_yticks(y, order)
    ax.set_xlabel("Share of rejected real strikes failing this gate (%)  — a strike can fail several")
    ax.legend(loc="lower left", bbox_to_anchor=(0, 1.0), ncol=3)
    fig.suptitle("Why real strikes were rejected", x=0.012, y=0.975, ha="left", fontsize=28,
                 fontweight="bold", color=S.INK)
    S.footnote(fig, "no_candidate = the segmenter never opened a candidate over the strike.")
    return S.save(fig, out, "02_reject_reasons_by_speed")


def fig_overlays(df, out):
    st = df[(df.role == "strike") & ~df.has_gap]
    fig, axes = S.new_fig(2, len(REAL_ACTIONS), sharey="row")
    fig.subplots_adjust(left=0.07, right=0.99, top=0.82, bottom=0.09, wspace=0.08, hspace=0.38)
    u = np.linspace(0, 100, PROFILE_POINTS)
    for j, act in enumerate(REAL_ACTIONS):
        top, bot = axes[0, j], axes[1, j]
        for sp in SPEEDS:
            g = st[(st.label == act) & (st.speed == sp)]
            for _, r in g.iterrows():
                n = r["stroke_ms"]
                top.plot(u / 100 * n, r["_profile"] * r["peak_gyro"], color=SPEED_COLOR[sp], lw=1, alpha=0.55)
                bot.plot(u, r["_profile"], color=SPEED_COLOR[sp], lw=1, alpha=0.35)
            if len(g):
                bot.plot(u, np.vstack(g["_profile"]).mean(0), color=SPEED_COLOR[sp], lw=3.2, label=sp)
        top.set_title(act, fontsize=20)
        for a in (top, bot):
            a.tick_params(labelsize=13)
        top.set_xlabel("ms", fontsize=14)
        bot.set_xlabel("% of stroke", fontsize=14)
    axes[0, 0].set_ylabel("rotation rate (dps)", fontsize=16)
    axes[1, 0].set_ylabel("÷ own peak", fontsize=16)
    axes[1, 0].legend(fontsize=14, loc="lower center")
    fig.suptitle("Same strike, different speed: raw (top) vs time- and peak-normalised (bottom)", x=0.012,
                 y=0.975, ha="left", fontsize=26, fontweight="bold", color=S.INK)
    S.footnote(fig, "Rotation about each stroke's own peak axis. Thin lines = reps, thick = mean per speed. "
                    "Strokes with a lost stream packet are left out.")
    return S.save(fig, out, "03_strike_profiles_by_speed")


# ------------------------------------------------------------ features

def eta2(values, labels):
    v = pd.Series(values)
    gm = v.mean()
    tot = ((v - gm) ** 2).sum()
    if tot == 0:
        return 0.0
    between = sum(len(g) * (g.mean() - gm) ** 2 for _, g in v.groupby(labels.to_numpy()))
    return float(between / tot)


def auc(pos, neg):
    pos, neg = pos.dropna(), neg.dropna()
    if len(pos) < 3 or len(neg) < 3:
        return np.nan
    a = roc_auc_score(np.r_[np.ones(len(pos)), np.zeros(len(neg))], np.r_[pos, neg])
    return max(a, 1 - a)


def rank_features(df):
    st, fk, rt = groups(df)
    rows = []
    for f in MAGNITUDE + INVARIANT:
        ratios, etas = [], []
        for act in REAL_ACTIONS:
            g = st[st.label == act]
            s, fa = g[g.speed == "slow"][f].median(), g[g.speed == "fast"][f].median()
            if pd.notna(s) and pd.notna(fa) and s != 0 and np.sign(s) == np.sign(fa):
                ratios.append(abs(np.log2(fa / s)))
            if g[f].notna().sum() > 5:
                etas.append(eta2(g[f].dropna(), g.loc[g[f].notna(), "speed"]))
        rows.append({
            "feature": f, "kind": "magnitude" if f in MAGNITUDE else "shape",
            "fast_over_slow": 2 ** np.median(ratios) if ratios else np.nan,
            "speed_eta2": np.median(etas) if etas else np.nan,
            "auc_strike_vs_fake": auc(st[f], fk[f]),
            "auc_slow_strike_vs_fake": auc(st[st.speed == "slow"][f], fk[f]),
            "auc_strike_vs_return": auc(st[f], rt[f]),
        })
    return pd.DataFrame(rows).set_index("feature")


def fig_feature_map(rank, out):
    fig, ax = S.new_fig()
    fig.subplots_adjust(left=0.08, right=0.97, top=0.85, bottom=0.12)
    for f, r in rank.iterrows():
        c = S.ORANGE if r.kind == "magnitude" else S.BLUE
        ax.scatter(r.speed_eta2, r.auc_slow_strike_vs_fake, s=160, color=c, zorder=3)
        ax.annotate(FEATURE_NAME[f], (r.speed_eta2, r.auc_slow_strike_vs_fake), xytext=(9, 5),
                    textcoords="offset points", fontsize=14, color=S.INK_2)
    ax.scatter([], [], s=160, color=S.ORANGE, label="magnitude (what the gates use now)")
    ax.scatter([], [], s=160, color=S.BLUE, label="shape / normalised")
    ax.set_xlabel("Speed dependence  (share of within-action variance explained by speed, η²)  →  worse")
    ax.set_ylabel("Slow strikes vs fakes  (AUC, 0.5 = useless)")
    ax.set_xlim(-0.03, max(0.95, rank.speed_eta2.max() + 0.05))
    ax.set_ylim(0.45, 1.02)
    ax.legend(loc="lower right")
    fig.suptitle("Good features sit top-left: they separate real from fake and ignore speed", x=0.012,
                 y=0.975, ha="left", fontsize=26, fontweight="bold", color=S.INK)
    S.footnote(fig, "Median η² over the six actions. AUC folded so direction doesn't matter.")
    return S.save(fig, out, "04_feature_map")


# ------------------------------------------------------- method compare
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
