leexianhui/CG4002/(commit log)

2026-09-10 Comms subsystem: relay, engine, protocol, mocks, demo rig
2026-09-20 Add M1-M3 triggered-action capture: button-tagged windows, ACTION_RECOGNIZED, Unity HUD
    Implements NOW/NEXT scope of docs/DEMO_TRIGGERED_ACTION_PLAN.md: firmware tags a bounded
    40-frame IMU capture per action-button press (weapon + 3 action buttons, GPIO 4/25/26/27),
    the relay's PlayerWindower runs an arm/count/emit/refractory state machine in trigger_mode
    to emit exactly one SensorWindow per press, the Ultra96 sim classifies against a
    (weapon, triggerId) map, and the engine broadcasts ACTION_RECOGNIZED (including the
    guard action=IDLE/guardState=GUARDING case) to a new minimal Unity HUD scene proving the
    full P1 chain end-to-end. M4 (temp P2 combat), M5 (real P2), M6 (real positioning), and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
2026-09-20 Bring up temporary P2 ESP32 dev-bench board
    Add env:esp32dev_p2 build target with player-2 identity overridden via
    build flags (#ifndef guards in cg_config.h let CG_DEMO_PLAYER_ID and
    CG_DEMO_BLE_DEVICE_NAME be set per-environment instead of hardcoded).
    Fill in relay.p2.yaml's missing trigger_mode, BLE char UUIDs, and host
    placeholders to mirror relay.p1.yaml's proven config.
    Also carries the EngineClient reconnect fix (guard against a second
    Connect() racing a stale socket after Android backgrounding) that was
    tested and confirmed working on the P1 rig.
2026-09-20 Fix firmware reliability gaps causing stuck-weapon suppression and link_degraded
    Two defects in firmware_demo/src/main.cpp, both device-side only:
    - RFID_EVENT is a RELIABLE_PACKET_TYPES packet, but the firmware fired it once
    and never retransmitted on a dropped notification. The relay would never
    learn the weapon changed, so every action after that press suppressed at
    the weapon-chosen gate even though the board's own serial log showed the
    weapon as set. Added a pending-send slot + service_pending_rfid_event(),
    mirroring cg_comms/relay/reliability.py's ReliabilitySender (200ms base,
    x2 backoff, 5 attempts).
    - drain_incoming_non_blocking() returned on a replay-window duplicate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
2026-09-20 Fix retransmit unACKability, handshake-reset ordering, add window_suppressed diagnostics
    Follow-up to e0ae2c3, which fixed the stuck-weapon/link_degraded pair but introduced a
    regression and left a pre-existing bug unaddressed:
    1. RFID_EVENT retransmit re-encodes with a fresh seq instead of resending identical frame
    bytes. The relay's replay window (codec.decode_packet -> SequenceTracker.accept) rejects
    a repeated wire seq as DropReason.REPLAY before packet-type dispatch even runs, so every
    retransmit of identical bytes was unconditionally unACKable (stream_decode_drop
    reason=replay). Re-encoding mints a fresh nonce and decodes cleanly; safe because
    on_weapon_confirmed/Weapon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
2026-09-20 Detect and reduce BLE notify drops causing span-gate window suppression
    The P2 span suppressions were not transport latency and not a stalled
    device loop: serial showed a flat sensor_frames=50/s while the relay's
    span gate saw ~28-36ms per frame. The frames were generated on time and
    then discarded on-chip.
    BLECharacteristic::notify() returns void. On a controller-level failure
    it logs "esp_ble_gatts_send_notify: rc=-1" (ESP_FAIL, tx buffer full)
    and returns, so send_packet() reported success for every dropped frame.
    A 50Hz stream that never reached the air looked perfectly healthy.
    - Register a status callback on the notify characteristic and check it
    after each notify(), so send_packet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
2026-09-22 Validate guard facing and add classifier latency diagnostics
    Face the demo avatars toward each other without changing local scene connection
    settings. Log the guard geometry used for resolution and identify rejected
    events by message type, reason, source time, and normalized engine time.
    Measure classifier encoding, transport wait, and simulator service time. Add an
    isolated latency probe and hardware retest procedure while retaining existing
    timeout and reorder defaults.
    Validation: 248 Python tests passed, including 30 new regression tests; focused
    Ruff checks and Python 3.10 grammar checks passed. Physical retesting remains
    required. Only the four avatar rotation lines are included from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
2026-09-23 Freeze assessment wire contract and transform, fix latent reliability bug
    Adds the four packet types the comms-assessment demo needs (0x40-0x43) to both
    sides of the wire contract, plus the device-side transform that makes the echo
    round trip verifiable rather than merely observable.
    Fixes a latent bug found while doing it: codec.py hard-coded
    (RFID_EVENT, COMBAT_FEEDBACK) inline in TWO places, so adding a type to
    RELIABLE_PACKET_TYPES alone did nothing -- the retransmit cache never held it
    and a duplicate was re-applied instead of re-ACKed. Both sites now read one
    shared ACK_RETRANSMIT_PACKET_TYPES set.
    Three design choices avoid known hard edges rather than patching them:
    - Only the lapt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
2026-09-23 Implement comms assessment: echo pipeline, verified file transfer, throughput stats
    - Relay keyboard (lowercase/digits/space = echo, F = file, D = packet view, Q = stop):
    one op at a time, rejected with a reason (BUSY/OFFLINE/NO_WEAPON/UPSTREAM_OFFLINE), never queued
    - Echo: randomised ASSESS_ECHO_REQ, FireBeetle transform verified against send-time expectation,
    continues through the normal window -> Ultra96 -> engine -> visualizer path; timeout counts lost,
    late/duplicate responses logged as info rather than unknown-trace warnings
    - File transfer: 32 B chunks, device running CRC checked per chunk, lost FILE_ACK recovered by
    exact retransmit without double-append; deterministic 1037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
2026-09-27 Make keyboard assessment deterministic with board-owned weapon selection
    Add fixed live-editable B/C/D identity round trips, reliable weapon cycling, optional content-based simulator classification, concise trace logs and an operator runbook. Preserve GPIO capture, file transfers and normal streaming. Validate with 385 Python tests and both normal firmware builds.
2026-10-02 Strip comms-assessment extension and tidy repo for remaining subsystems
    The individual Comms assessment is done; its code and docs are archived in
    4302c32 and recoverable from history.
    - Remove ASSESS_* wire types (0x40-0x47) from Python, cg_protocol.h, the
    firmware and the golden vectors; 0x40-0x4F is now marked reserved and
    must never be reassigned. Protocol VERSION is unchanged, so gameplay
    layouts still interoperate with older firmware.
    - Remove relay/mock assessment pipelines (echo/file/keyboard/dummy/
    transform/throughput), assessment_timing, assessment_fixture, their
    tests, CLI entry points and bench PlatformIO envs.
    - Drop the optional demoTraceId from schemas, models and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
2026-10-15 Integrate AI subsystem and reorganise repo into four subsystem folders
    AI (ai/, from AI_Integration_Codes, files kept as supplied):
    - Add ai/comms_server.py: the classifier service the relay talks to on :8888.
    Speaks the relay's SENSOR_WINDOW/ACTION_RESULT contract (echoes requestId,
    timestamp, playerId) and runs the AI team's own model code: float,
    bit-accurate fixed point, or FPGA via PYNQ.
    - Add ai/data_utils_lite.py, a stand-in for a module the drop imported but
    did not include.
    - AI-only classes SPIN_ATTACK/UPPERCUT map to IDLE until they get game rules;
    no GUARD model was supplied, so guard is always IDLE.
    - Hardware relay configs: 100-sample windows (the model's trained inpu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
2026-10-16 Adapt the AI team's classifier_server.py at its comms boundary instead of a parallel server
    - Remove ai/comms_server.py. ai/classifier_server.py stays the one AI
    service; only its comms-facing parts changed: reads dominant/offhand,
    echoes requestId/playerId/timestamp unchanged, adds version, maps AI-only
    classes (SPIN_ATTACK, UPPERCUT) to IDLE via COMMS_ACTION_MAP (original
    label in aiAction), loads only the models present (SWORD fallback, guard
    IDLE without a GUARD model). Model maths and FPGA code untouched.
    - Move the supplied model to ai/models/SWORD/, the layout classifier_server.py
    and fpga_infer.py already expect.
    - client_test.py sends the relay's request format and check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
2026-10-16 Setup guide: per-machine secrets table; one PSK for both hubs and relays
2026-10-17 Add simulated-P2 relay config and guide steps for single-player hardware testing
2026-10-17 Hub: free Classic-BT controller memory before BLE init and drop the raw sample stream
    P1 hub aborted in BLEDevice::createServer() (operator new -> bad_alloc) once BLE and Wi-Fi
    both ran next to the hardware sketch. Only BLE is used, so release the Classic-BT controller
    memory first, and log free heap before init. RAW_STREAM=0 on hubs: the laptop analysis
    stream is not used by the game.
2026-10-17 Hub stays scannable when sensor nodes are online
    Once the torso and left wrist joined, the hub stopped appearing in BLE scans: its single
    radio was busy with Wi-Fi broadcasts. Turn off the RAW_STREAM analysis broadcast on every
    gateway board, prefer BT in Wi-Fi/BT coexistence on the hub, and advertise every 20-40 ms.
2026-10-17 Hub: give Wi-Fi radio time back while a relay is connected; quieter relay suppression logs
    With a relay connected the hub never heard the torso/left wrist (LEDs stayed yellow):
    BLE took the shared radio. Revert the PREFER_BT coexistence change to BALANCE and request
    15-30 ms BLE connection events on the hub instead of 7.5-15 ms. The demo board is unchanged.
    Continuous-mode relay logs window_suppressed when the reason starts or changes, not on
    every 200 ms stride (no_weapon before the weapon locks flooded the console).
2026-10-17 Hardware hub sends one segment per accepted action instead of a 50 Hz stream
    The hub's own segmenter already decides when an action happened (acceptSegment ->
    sendSegmentToUltra96, previously a logging stub). In the new default event mode
    (CG_GATEWAY_EVENT_MODE=1) that stub hands the accepted right-wrist samples to the BLE
    task, which sends them once as SEGMENT_CHUNK packets, and the relay sends exactly one
    classifier request per complete segment. Nodes stop their 50 Hz sample broadcast, so the
    hub's single radio is no longer saturated by continuous BLE frames plus UDP samples.
    - Protocol: SEGMENT_CHUNK 0x12, 208-byte payload (16 samples), 234 bytes on the wire.
    ACK + identical-ciphertext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
2026-10-17 Pull hardware upstream b23a43c: per-weapon action templates and limits
    Brings hardware/ up to xhuinn/cg4002-hw b23a43c (Differentiate weapon templates).
    Hub sketches get per-weapon strike/thrust limits and thrust templates refitted
    from 76 sessions; gateway hooks and the segment uplink are untouched. Offline
    fitting tools and docs copied as-is; the 25 MB '2 players.zip' is left out.
2026-10-18 Hardware boards link to their hub over BLE; no Wi-Fi on any board
    The hub crash-looped at BLE init (assert in vQueueDelete: Bluedroid out of
    heap, 91 KB free) once the segment uplink was added on top of Wi-Fi, and with
    Wi-Fi it also stopped hearing its nodes while the relay was connected (one
    radio, LEDs stuck yellow).
    CG_GATEWAY_NODE_LINK=1 (default): torso and left wrist are BLE GATT servers
    with a player/role-specific service UUID; the hub, still the relay's
    peripheral, is their central (scan, connect, notify node->hub, write
    hub->node). The sketches' WiFiUDP sockets become GatewayLinkUdp, a drop-in
    keyed by port, and their Wi-Fi join is skipped, so their send/receive logic is
    unchanged.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
2026-10-18 Setup guide: fix the simulated P2 relay command split across two lines
2026-10-18 Visualizer: phone only picks its player; endpoint and engine token are filled in
    Endpoint now defaults to ws://127.0.0.1:8080 (the phone's socat) in the script and OnlineScene.
    The engine token ships in Resources/engine_token.txt; EngineTokenBuildStep refreshes it from
    comms/.env.engine (or .env.relay) before each build and on editor load. The phone remembers the
    last player it connected as. Tests opt out of saved settings.
2026-10-19 Visualizer Android: OpenGLES3 ahead of Vulkan so the ARCore camera feed renders
    With Vulkan first, URP also needs ARCommandBufferSupportRendererFeature, which the renderer
    lacked: the AR scene drew over a black background. iOS (Metal/ARKit) is unaffected. Also
    keeps the Android build's generated ARCore marker data and Android batching settings.
2026-10-19 Relays talking to the real AI wait 300 ms for a classification, not 120 ms
    The NumPy classifier on the Ultra96 ARM answered in 23-90 ms but occasionally took 128-135 ms;
    each of those dropped the swing and reset the classifier connection.
2026-10-19 Visualizer: collapsible connection panel; setup readings show each player's weapon
    The panel covered the HUD. 'Hide panel' shrinks it to one small P1/P2 + phase button (tap to
    reopen), and it collapses by itself once the match is running. The setup readings now list each
    player's locked weapon, the usual reason a match stays WAITING.
2026-10-19 Pull hardware upstream 0dea955: more lenient sword/shield action limits
    Brings both hub sketches up to xhuinn/cg4002-hw 0dea955 (adjust limits). Sword/shield only:
    horizontal/diagonal strike distance 1.75 (was 1.50); a relaxed uppercut match (24 deg axis spread,
    distance 2.25) gated on rotation, peak rate and torso motion; thrust tolerates 65 deg of wrist
    rotation, distance 1.50 for pushes >= 1.5 g and 1.10 for weaker ones, and a high-rotation push must
    reach 0.65 m. Gateway hooks and the segment uplink are unchanged.
2026-11-04 Update prop tracking image set.
2026-11-04 Visualizer: in-app SSH tunnel replaces Termux ssh + socat (Android and iPhone)
    PhoneTunnel.cs (SSH.NET 2024.2.0 + BouncyCastle in Assets/Plugins/SshNet, link.xml for IL2CPP)
    opens ssh -J stujump -> board -L 8443 on Connect and does socat's TLS step on 127.0.0.1:8080,
    so neither phone needs Termux. Logins come from Resources/ssh_tunnel.txt; blank passwords are
    typed in the connection panel. Off in the editor; the panel toggle falls back to Termux.
2026-11-04 AI: final 18-channel ACTION_FINAL + GUARD_FINAL models and bitstream, comms boundary restored
    - ai/cnn.bit (2026-11-04 build) and models/ACTION_FINAL, models/GUARD_FINAL from the AI team.
    config.py and fpga_infer.py stay as the AI team pushed them.
    - classifier_server.py keeps the AI team's logic (0.70 attack gate, guard hysteresis, guard
    priority, torso zeroed for GUARD) and restores what the relay needs: reads dominant/offhand
    (+ optional torso, or their 100x18 samples), echoes requestId/playerId/timestamp, sends
    version, GuardState IDLE/GUARDING, SPIN_ATTACK/UPPERCUT -> IDLE with rawAction kept.
    An absent or constant sensor block (the segment-mode off-hand placeholder) is fed as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
2026-11-04 Send the AI one 2 s window of all three IMUs per accepted attack; retire GUARD_FINAL
    Before this, only the right wrist reached the classifier: in event mode the torso and left wrist
    dropped their samples, the torso only logged "[Ultra96 send skipped]", and the relay sent a
    placeholder off-hand and no torso. ACTION_FINAL takes (100, 18): right, left, torso at 50 Hz.
    - Nodes stream their 50 Hz samples to the hub in event mode too. The hub keeps 4 s of all three
    boards on a 20 ms grid in hub time (GatewayHistory; node clocks via the smallest arrival offset).
    - The hardware team's segmenter still decides what is an attack. For each stroke it accepts, the
    hub cuts the 2 s window with the str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
2026-11-04 Low-pass the AI's gyro at 20 Hz to match how ACTION_FINAL was recorded
    The AI team's collector (imu_stream_3sensor.ino) ran on these same MPU6500 boards with the chip's
    DLPF on (0x1A = 4) and read it at 50 Hz: gyro filtered at ~20 Hz (~9.9 ms delay), accelerometer
    unfiltered (on the MPU6500 0x1A leaves it alone; the training data's accel noise is flat to 25 Hz
    while its gyro noise falls off). The game sketches keep the DLPF off for their own swing detection
    and read at 100 Hz, so the AI was getting raw gyro.
    Every board now runs the gyro it exports to the AI through GatewayLowPass (2nd-order Butterworth,
    20 Hz at 100 Hz, ~9.8 ms delay), on every 100 Hz sample, before every other one is kept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
2026-11-05 AI: rebuilt cnn.bit + matching cnn.hwh (2026-11-05) for ACTION_FINAL
    The 2026-11-04 cnn.bit still held the old 6-channel CNN (its DMA finished after exactly
    1 + 600 words, so 1801-word windows timed out on the board). This pair comes from one
    Vivado 2018.2 rebuild: the hwh differs from the old one only in the CNN core's latency
    (632106 -> 397962 cycles), so the core was regenerated. To confirm on the board:
    fpga_infer.py --bit cnn.bit must print bit-exact 68 / 68.
2026-11-05 AI: fpga_probe.py finds the input size the FPGA's CNN core really takes
    fpga_infer.py times out when cnn.bit's core was built for another input size. The probe bisects
    the exact word count on the board (reprogramming between trials), prints raw DMA status, names
    the likely cause (601 = old 6-channel core, 1800 = no model_id word), and at 1801 checks 10 test
    windows bit-exact against fixedpoint_ref. Run: sudo -E python3 fpga_probe.py
2026-11-06 Stop reporting real attacks as IDLE; same 6 AI attacks for every weapon; clearer AI/relay logs
    On the AI team's 59 test attacks the model itself says IDLE once, but classifier_server.py turned 20
    of them into IDLE: SPIN_ATTACK and UPPERCUT were mapped to IDLE (19), and any attack under a hidden
    0.70 cutoff became IDLE (1), although the system floor is 0.6 (relay min_confidence, match.yaml).
    - AI: report the model's top class as-is; the 0.6 floor stays in the relay/engine, so a weak answer
    is dropped under its real name. 20/59 -> 1/59 attacks reported as IDLE.
    - ACTION_FINAL is one weapon-agnostic model trained on all three weapons for the same 7 classes, so
    every weapon in weapons.yaml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
2026-11-07 AI: replace ACTION_FINAL with the retrained ACTION_corrected_v2 model
    Same architecture (18 ch, 100 x 50 Hz window, 7 classes, 5335 params, 375008 MACs), new weights and
    norm.json. Test set is now 75 windows: 69/75 (0.92) float and fixed-point, macro F1 0.921.
    hls/board_testset.npz regenerated from the new test_data.npz (model_id 0).
    cnn.bit still holds the previous model's weights, so the fpga backend will not match the
    numpy/fixed backends until the bitstream is rebuilt with these weights.
2026-11-07 Relay: wait 12 s (was 2 s) for a hub segment's chunks before abandoning it
    P1's BLE link to the relay laptop delivered every chunk but took ~3.2 s per action
    ("[segment] sent ... chunks=20 in 3217ms" on the hub), so the relay abandoned each one at 2 s
    and the late remainder started a second partial that could never complete (13 + 7 = 20 chunks).
    The hub sends one segment at a time and re-sends an unACKed chunk for ~4.6 s, so a longer wait
    cannot mix chunks of different actions; 12 s is ~4x the slowest P1 delivery seen. The engine
    stamps actions on arrival, so a late one still counts. P1's slow link itself is still radio-side.
2026-11-07 AI: replace ACTION_FINAL with the retrained ACTION_sword_v3 model
    norm.json. Test set is now 98 windows: 94/98 (0.959) float and fixed-point, macro F1 0.961.
    cnn.bit still holds an older model's weights, so the fpga backend will not match the numpy/fixed
    backends until the bitstream is rebuilt with these weights.
    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
2026-11-07 AI: cnn.bit + cnn.hwh from the 2026-11-08 Vivado build (DMA can reach all 2 GB DDR)
    The axi_dma_0 MM2S/S2MM address range for HP0_DDR_LOW is now 2G (0x00000000-0x7FFFFFFF); the
    previous build mapped only 1G, so buffers PYNQ allocated above 1 GB failed with DECODE_ERR and
    fpga_infer.py timed out. Same block design otherwise (axi_dma_0 32-bit, no SG, cnn_top_0, xczu3eg).
2026-11-07 AI: fpga_probe.py tests the 1801-word transfer first and dumps DMA registers
    Tries 1 + 100*18 = 1801 words directly instead of bisecting, stops on any DMA error bit (a DMA error
    means memory/interconnect, not input size), and prints buffer physical addresses and the MM2S/S2MM
    registers. --compare N checks N ACTION_FINAL test windows bit-exact against fixedpoint_ref;
    --timeout defaults to 1.5 s.
2026-11-07 AI: add fpga_split_test.py, sends the 1801 input words as 1024 + 777 DMA packets
    Diagnostic only: arms S2MM for 7 logits, sends two MM2S transfers (1024 then 777 zero words),
    refuses buffers outside low DDR (< 1 GB), and prints MM2S/S2MM status on success or failure.
    Needs an HLS read_input that ignores TLAST and reads a fixed 1801 words.
2026-11-07 AI: fpga_infer.py sends each window as two DMA packets (1024 + 777 words)
    The HLS cnn_top reads a fixed 1801 words and ignores input TLAST, so the input is split into
    1024 + 777 word MM2S transfers (shown working on the Ultra96). Buffers must sit in low DDR (< 1 GB),
    DMA error bits are checked, timeout defaults to 5 s, and FpgaEngine has close(). The self-test runs
    the first --limit windows (default 10, 0 = all). FpgaEngine(bit) / infer(model_id, x) are unchanged,
    so classifier_server.py --backend fpga works as before.
2026-11-08 AI: cnn.bit + cnn.hwh from the 2026-11-08 10:47 Vivado build
    Same block design as the previous pair (axi_dma_0 32-bit no SG, cnn_top_0, xczu3eg, DMA reaches
    HP0_DDR_LOW 0x00000000-0x7FFFFFFF); the hwh differs from the last one only in its timestamp and
    the listing order of two cnn_top_0 clock/reset connections. New bitstream contents.
2026-11-08 Add shield prop tracking and image rendering
2026-11-08 Change prop images
2026-11-09 Hardware guard reaches the game: 3 s guard, 0-damage block; hub buzzes only for AI-confirmed actions
    Guard (xhuinn's left-wrist pose detection) previously stopped at the hub, which only buzzed and
    printed it. Now:
    - Hub -> relay: new reliable GUARD_EVENT (0x13, 8 B: hub ms, state, weapon), ACK + retry like the
    weapon packet. The hub sketches hand each edge to the gateway (gatewayGuardEvent); a newer edge
    supersedes an unACKed one, an edge older than 1 s (relay away) is dropped.
    - Relay: GUARDING becomes a guard-only ACTION (IDLE + GUARDING) to the engine; the release edge is
    logged only (guard_received ... forwarded=).
    - Engine: match.yaml guard_duration_ms 3000 (guard judged at each a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
2026-11-09 Relay: wait 1 s (was 300 ms) for the classifier before timing out
    Through the SSH tunnel and jump host, with a ~30 KB window per swing, classifier replies took
    ~30-250 ms on the rig (2026-11-09), so the slow tail hit the 300 ms limit. Each timeout dropped
    the swing and closed the classifier connection (logged as "classifier EOF"), so the next swing
    could be lost to the reconnect too. 1 s still catches a wedged classifier.
2026-11-09 AI: ACTION_FINAL v4 (757 recordings) + cnn.bit rebuilt 2026-11-09 22:45
    Model: same architecture (18 ch, 100 x 50 Hz, 7 classes, 5335 params). Random-split test
    110/114 (0.965), float == fixed-point on 114/114; leave-one-person-out mean 0.694 (v3 0.681).
    cnn.bit: new bitstream (2026-11-09 22:45), meant to carry the v4 weights. cnn.hwh unchanged
    (same block design, DMA reaches 2 GB). Verify on the board: fpga_infer.py --bit cnn.bit --limit 0
    should report bit-exact 114/114.
    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
2026-11-12 Hardware: P1 action bank, commitment gate, stricter and robust guard
    Valid-action detection (both hubs, identical apart from PLAYER_ID):
    - P1_LENIENT_MODEL: P1's own forward strokes as a weapon-agnostic fallback
    bank (built and audited by lenient_p1.py); former P2-only rules now apply
    to both players.
    - Commitment gate on every accept path: rejects wrist flicks, slow
    back-swings/lowering, guard raises, short or wrist-snap "thrusts", and
    low-torso horizontal/diagonal flicks (full-power cuts exempt).
    - Strokes within 600 ms of a guard entry/exit are rejected; swings while
    the guard is held count.
    Guard (left wrist):
    - Per-reference radii, arm distance and arrival speed; extra P1 ref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
2026-11-12 Update setup flow to have auto calibration. Add a restart match button in panel. Add guarding label when guarding. Update HUD
2026-11-13 Hub cannot lock a weapon until that player's phone has calibrated
    Players handle the phone before the headset goes on, often in a weapon pose, which locked a weapon
    before setup. The hub now ignores weapon poses until the phone's calibration (the look-and-hold,
    VISUALIZER_READY) is done.
    - Engine: tells each connected relay WEAPON_SELECT_ALLOWED once that player's phone is ready and
    WEAPON_SELECT_BLOCKED otherwise (always allowed without require_visualizer_ready); re-sent when a
    relay reconnects. Logged as weapon_selection.
    - Carried as COMBAT_FEEDBACK codes 5/6 (intensity 0, never a buzz), so it shares the one reliable
    relay->hub channel and stays in order with the buzzes. The relay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
2026-11-13 Match reset also unlocks each hub's weapon
    A reset (reset_match or the phone's RESTART) used to keep both weapons, in the engine and on the
    hubs (locked until reboot). Now it re-opens weapon selection end to end:
    - Engine: reset clears both weapons (positions kept), so the phones show weapon select again, and
    sends each relay WEAPON_UNLOCK (COMBAT_FEEDBACK code 7, intensity 0, not a buzz). Pending per
    player until that relay is connected; logged weapon_unlock.
    - Relay: forwards it, or holds it while the hub session is down and sends it first when the next
    session starts streaming (before the weapon-selection state).
    - Hub (game build): code 7 -> unlockWeapon(): releases an active guar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
2026-11-13 remove the unused charged attack
2026-11-13 Hardware debug logs over BLE to per-match CSVs in hardware/game
    In the BLE game build, board debug lines only reached each ESP32's Serial port, so stroke
    accept/reject reasons and guard decisions could not be reviewed after a game.
    - New best-effort DEVICE_LOG packet (0x14): 56-byte pieces of a debug line (source board,
    part, line_seq, 48 chars). cg_protocol.h, Python codec, wire_protocol.md, golden vector.
    - gateway_log: every sketch's debugLog() (and the hubs' resultLog()) calls gatewayLog().
    Torso/left wrist send pieces to the hub on the node link; the hub queues its own and its
    nodes' pieces and sends one per 20 ms, never while a segment is in flight. The hub's
    [guard]/[segment]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
2026-11-13 Fit the prop overlays to the real props
2026-11-13 Operator set-weapon command, and a live weapon lock-in countdown on the phones
    Set weapon (any stage, no reset):
    python -m cg_comms.tools.set_weapon --config configs/engine.integration.yaml --player 1 --weapon SPEAR
    - /control accepts {"type":"SET_WEAPON","version":1,"playerId","weapon"}; the engine sends that
    player's relay COMBAT_FEEDBACK WEAPON_SET_SWORD/_SPEAR/_MACE (codes 8-10, intensity 0, not a buzz),
    held until that relay is connected (a reset drops an undelivered one). The relay holds it for a
    hub that is reconnecting.
    - Hub (game build): forceWeapon() releases an active guard and locks the weapon at once, without the
    3 s hold or the phone gate; reported as a normal lock (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
